PreferLinux/open-source-multimeter/design idea.png

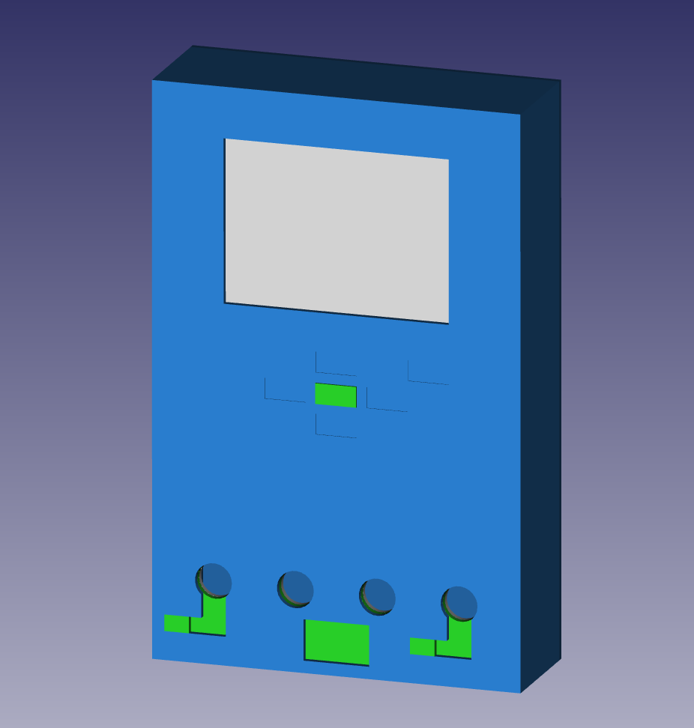
design idea.png
