PreferLinux/open-source-multimeter/README

The schematics and PCB layout are done in KiCAD.

Please see https://hackaday.io/project/10820-open-source-multimeter for details. There are also details in the schematics.
