PreferLinux/open-source-multimeter/voltage divider values.ods

Sheet: Voltage ranges
Desired resolution | Resultant peak | Resulting range | Required division | As a multiplication | Second resistor | Selected value | Actual division | Actual peak | Actual range | Actual resolution | Percentage deviation from desired | Comments
1.50E-01 | 600 | 424.2640687119 | 409.6 | 0.0024414063 | 24405.8130200685 | 2.40E+04 | 416.4894465681 | 610.0919627462 | 431.4001640052 | 0.1525229907 | 1.681993791 | These may seem high compared to my accuracy goals, but they don’t relate because these are basically the amount of rounding error between the calculated value and displayed value.
1.00E-02 | 40 | 28.2842712475 | 27.3066666667 | 0.0366210938 | 380063.779016726 | 3.90E+05 | 26.6365556775 | 39.0183921057 | 27.5901696489 | 0.009754598 | -2.4540197358
1.00E-03 | 4 | 2.8284271247 | 2.7306666667 | 0.3662109375 | 5778052.18489985 | 5.82E+06 | 2.7181929833 | 3.9817280029 | 2.8155068717 | 0.000995432 | -0.4567999275
1.00E-04 | 0.4 | 0.2828427125 | 0.2730666667 | 3.662109375 | 37564.1966250917 | 3.60E+04 | 0.2647058824 | 0.3877527574 | 0.2741826041 | 9.69381893382353E-05 | -3.0618106618 | These ranges are achieved with amplification of the signal rather than attenuation. Also used for current ranges.
1.00E-05 | 0.04 | 0.0282842712 | 0.0273066667 | 36.62109375 | 2807.3253646233 | 2.80E+03 | 0.0272373541 | 0.0398984679 | 0.0282124772 | 9.97461697470817E-06 | -0.2538302529
1.00E-06 | 0.004 | 0.0028284271 | 0.0027306667 | 366.2109375 | 273.814362419 | 2.70E+02 | 0.0026927296 | 0.0039444282 | 0.0027891319 | 9.86107042235963E-07 | -1.3892957764
Reference voltage | 3
Number of bits | 13
Max count | 4000
R1 for divider | 1.00E+07
R1 for amplifier | 1.00E+05
COM input resistor | 68

Sheet: Resistance current ranges
Desired resolution | Resultant peak V | Resulting I range | Required division | As a multiplication | Second resistor | Selected value | Actual division | Actual peak | Actual range | Actual resolution | Percentage deviation from desired | Comments
5.00E-05 | 0.2 | 0.002 | 0.1365333333 | 7.32421875 | 15812.2297714639 | 1.58E+04 | 0.1364421416 | 0.1998664184 | 0.1413268998 | 4.99666045984456E-05 | -0.0667908031 | These ranges are for measuring small currents for resistance calculations.
5.00E-06 | 0.02 | 0.0002 | 0.0136533333 | 73.2421875 | 1384.2327241268 | 1.37E+03 | 0.0135148466 | 0.0197971386 | 0.0139986909 | 4.94928464412548E-06 | -1.0143071175
Reference voltage | 3
Number of bits | 13
Max count | 4000
Shunt resistance | 100
R1 for amplifier | 1.00E+05
