PreferLinux/open-source-multimeter/External design.fcstd

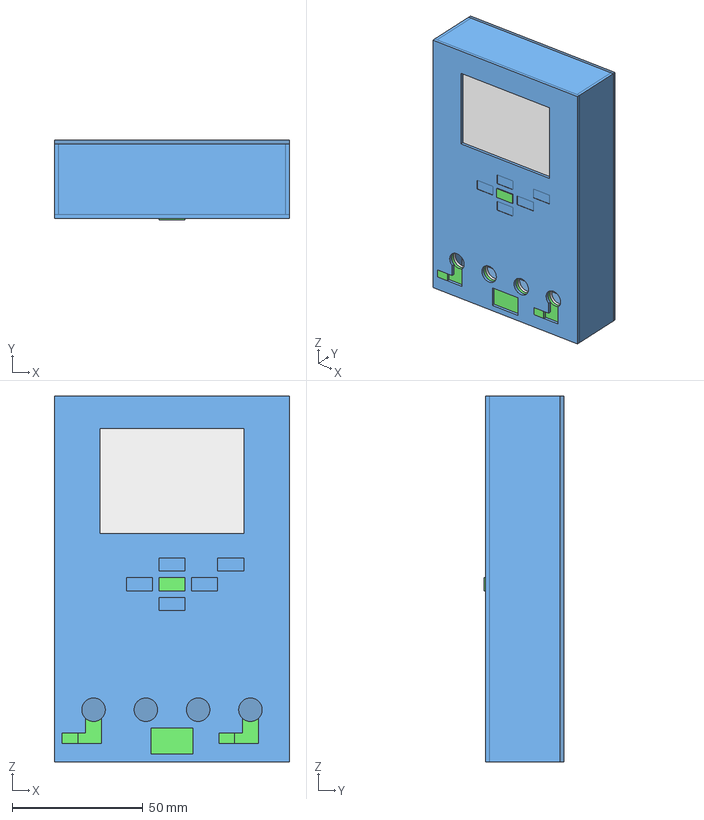
[picture p2: CAD file, 2016-07-02]
External design.fcstd
90.0 x 30.5 x 140.0 mm
