PreferLinux/open-source-multimeter/Multimeter.pdf

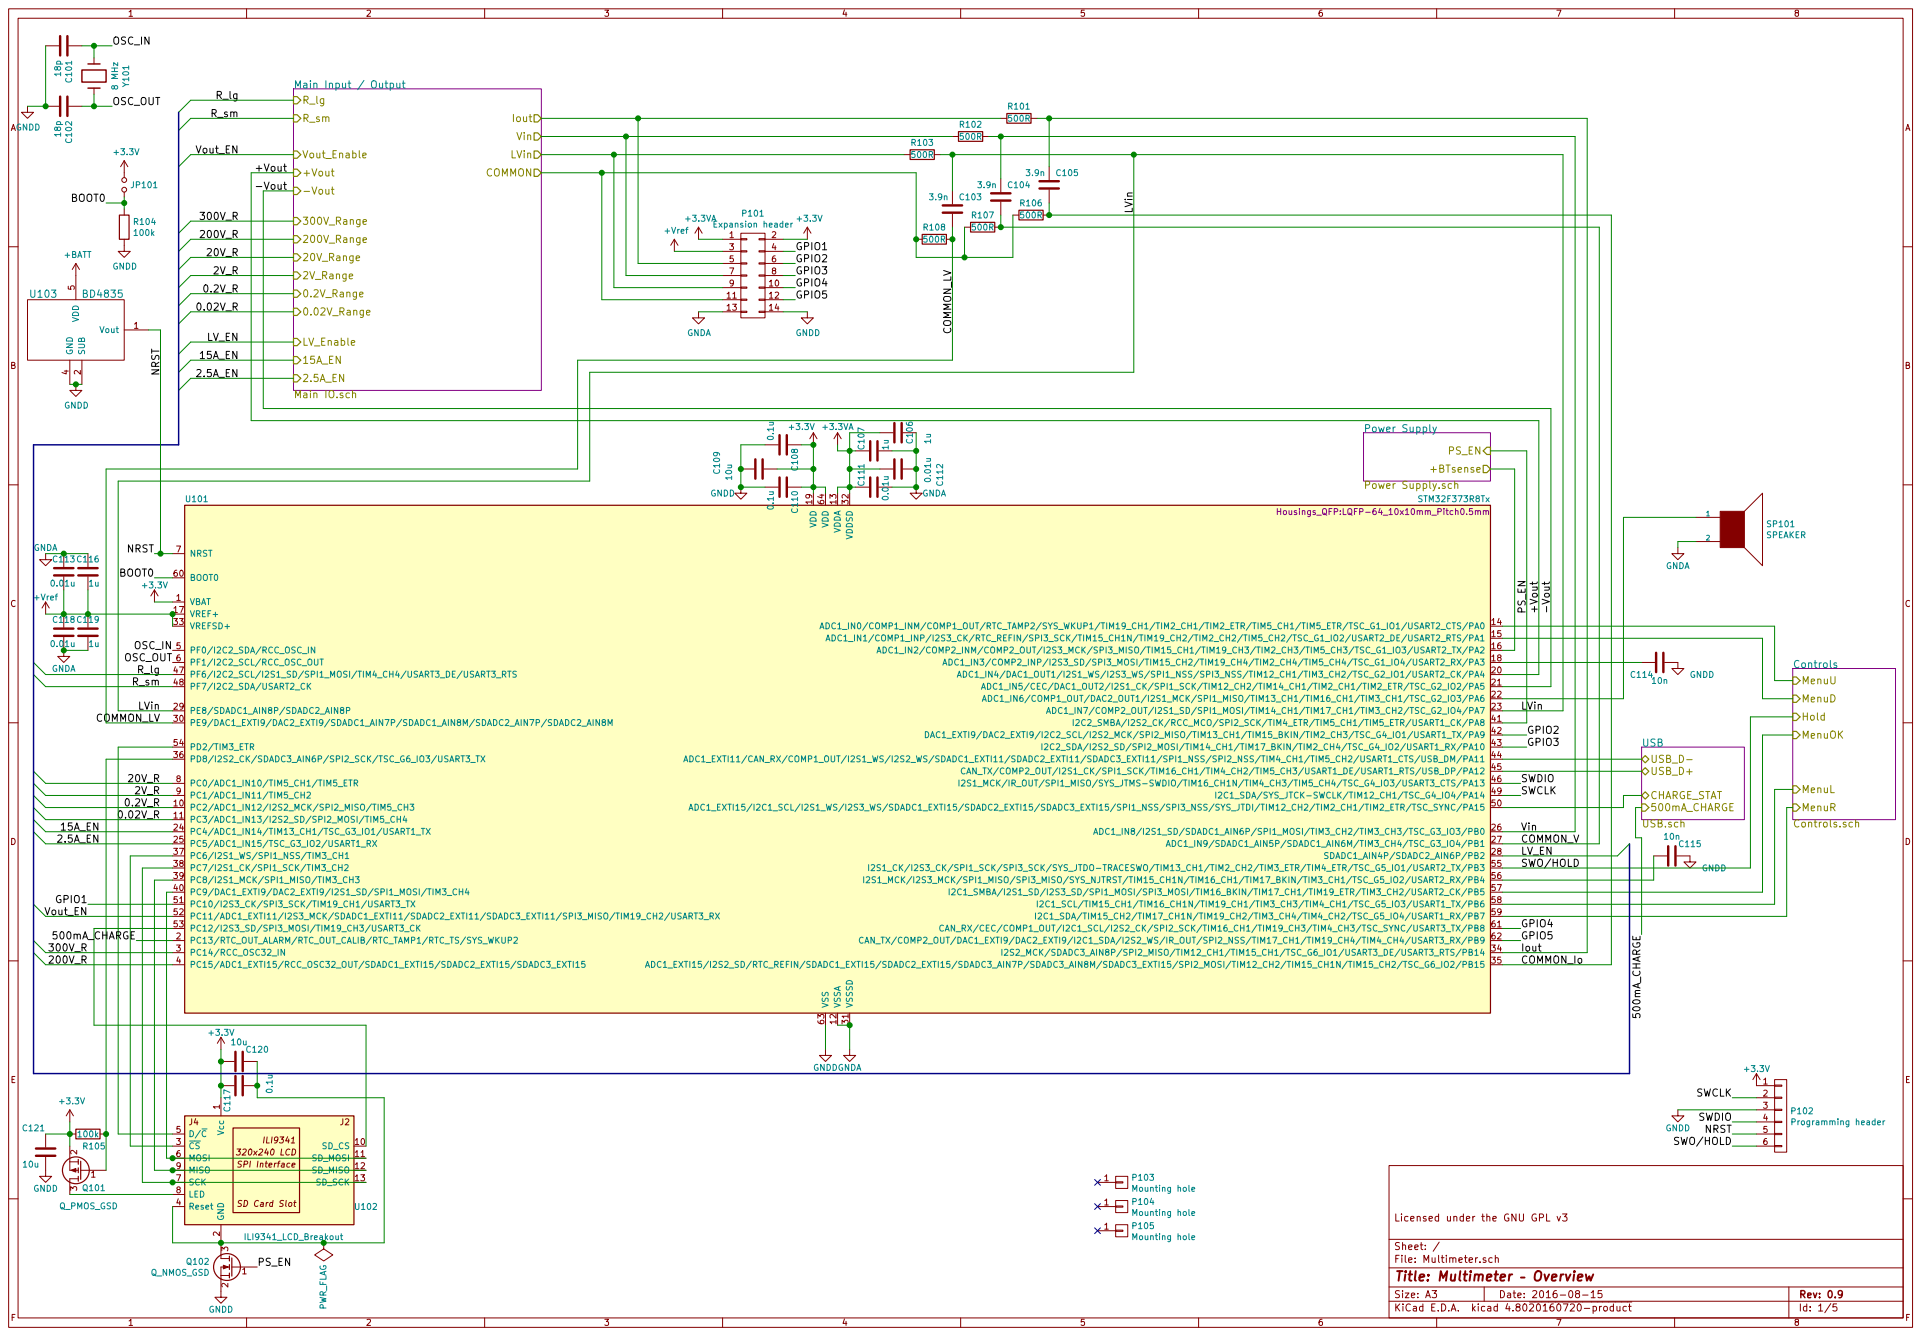
[picture p3: page 1]

Power Supply.sch
COMMON_V +Vout -Vout
Controls.sch MenuU MenuD
Hold MenuL MenuR MenuOK

2 CS 3 Reset 4 D/C 5 MOSI 6 SCK 7

File: Multimeter.sch Sheet: / Licensed under the GNU GPL v3

Id: 1/5 Title: Multimeter Overview

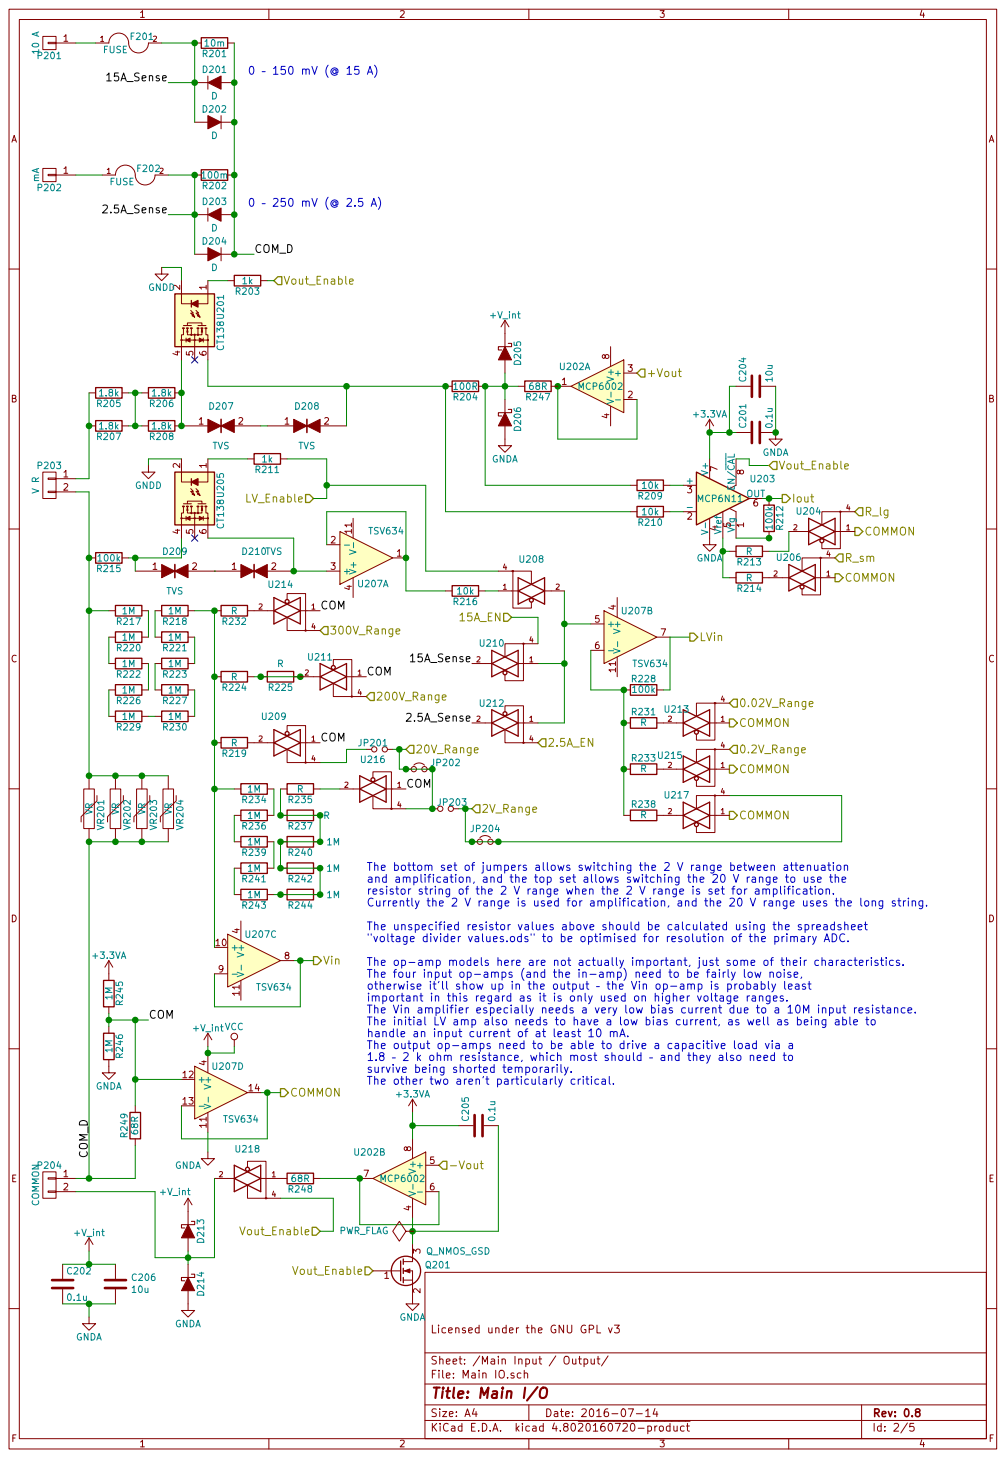
[picture p4: page 2]

The bottom set of jumpers allows switching the 2 V range between attenuation
and amplification, and the top set allows switching the 20 V range to use the
resistor string of the 2 V range when the 2 V range is set for amplification.
Currently the 2 V range is used for amplification, and the 20 V range uses the long string.
The unspecified resistor values above should be calculated using the spreadsheet
"voltage divider values.ods" to be optimised for resolution of the primary ADC.
The op-amp models here are not actually important, just some of their characteristics.
The four input op-amps (and the in-amp) need to be fairly low noise,
otherwise it'll show up in the output the Vin op-amp is probably least
important in this regard as it is only used on higher voltage ranges.
The Vin amplifier especially needs a very low bias current due to a 10M input resistance.
The initial LV amp also needs to have a low bias current, as well as being able to
handle an input current of at least 10 mA.
The output op-amps need to be able to drive a capacitive load via a
1.8 2 k ohm resistance, which most should and they also need to
survive being shorted temporarily.
The other two aren't particularly critical. 1

GNDA
File: Main IO.sch Sheet: /Main Input / Output/ Licensed under the GNU GPL v3

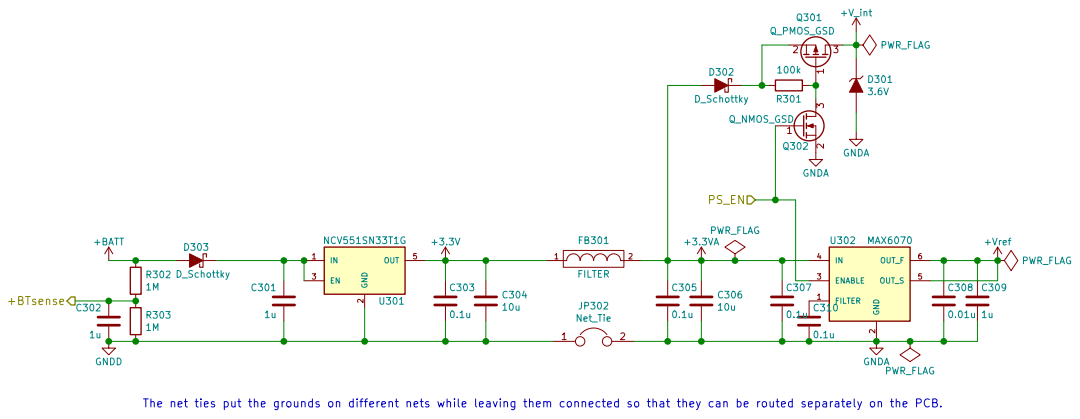
[picture p5: page 3]

Sheet: /Power Supply/ Licensed under the GNU GPL v3

File: Power Supply.sch
Id: 3/5 Title: Power supply

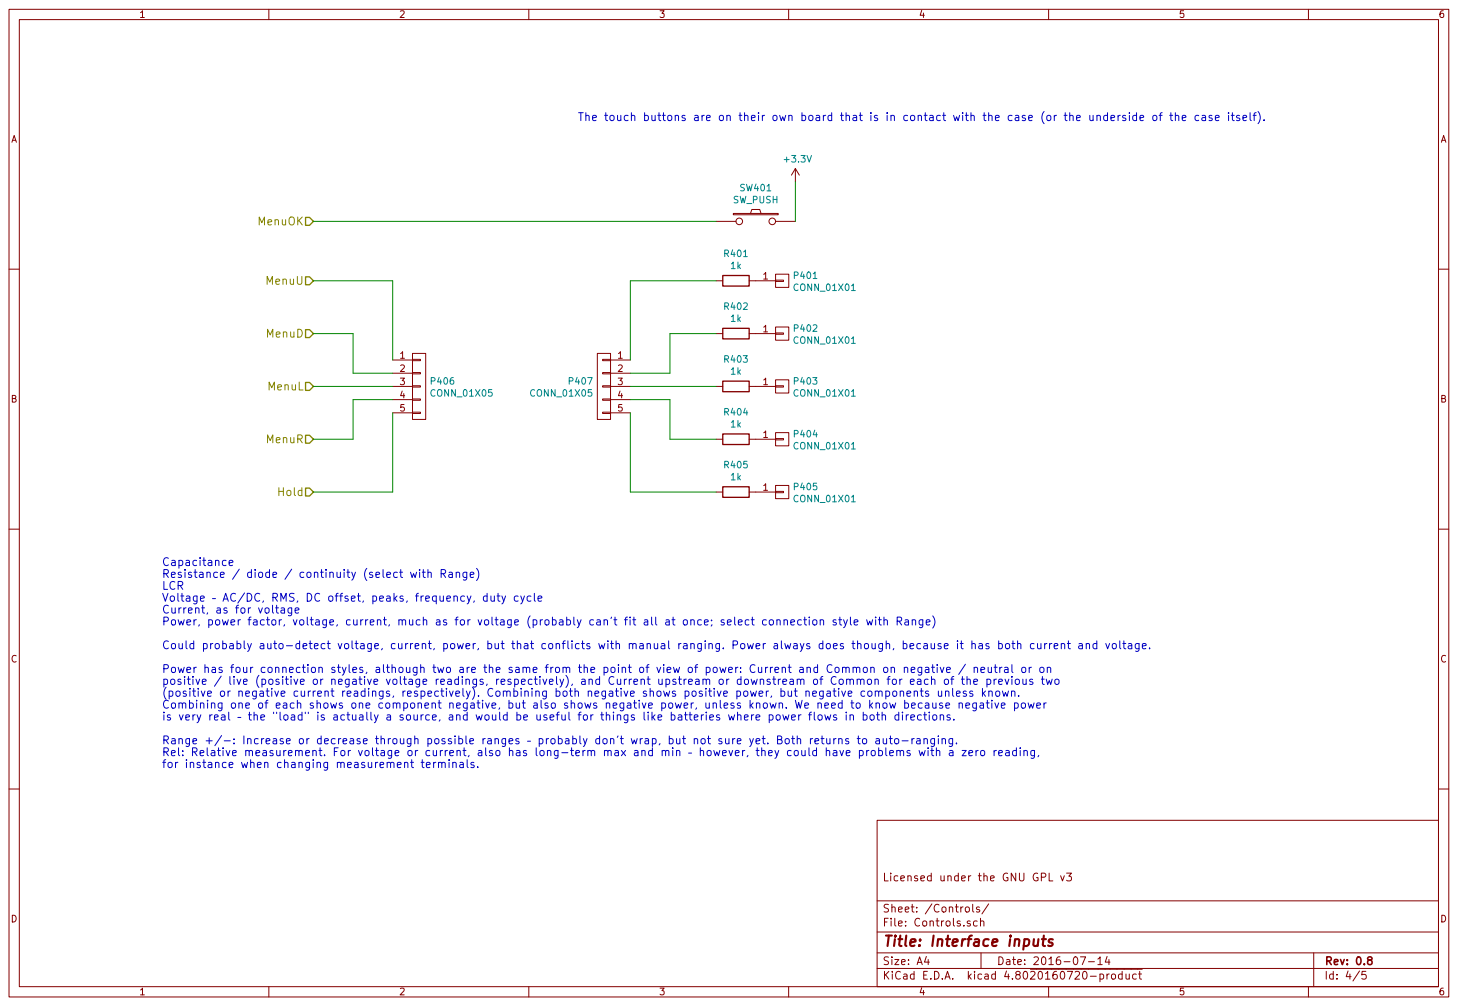
[picture p6: page 4]

The touch buttons are on their own board that is in contact with the case (or the underside of the case itself). 1

File: Controls.sch Sheet: /Controls/ Licensed under the GNU GPL v3 MenuU MenuD

Resistance / diode / continuity (select with Range)
LCR
Voltage AC/DC, RMS, DC offset, peaks, frequency, duty cycle
Current, as for voltage
Power, power factor, voltage, current, much as for voltage (probably can't fit all at once; select connection style with Range)
Could probably auto-detect voltage, current, power, but that conflicts with manual ranging. Power always does though, because it has both current and voltage.
Power has four connection styles, although two are the same from the point of view of power: Current and Common on negative / neutral or on
positive / live (positive or negative voltage readings, respectively), and Current upstream or downstream of Common for each of the previous two
(positive or negative current readings, respectively). Combining both negative shows positive power, but negative components unless known.
Combining one of each shows one component negative, but also shows negative power, unless known. We need to know because negative power
is very real the "load" is actually a source, and would be useful for things like batteries where power flows in both directions.
Range +/-: Increase or decrease through possible ranges probably don't wrap, but not sure yet. Both returns to auto-ranging.
Rel: Relative measurement. For voltage or current, also has long-term max and min however, they could have problems with a zero reading,
for instance when changing measurement terminals.

Id: 4/5 Title: Interface inputs

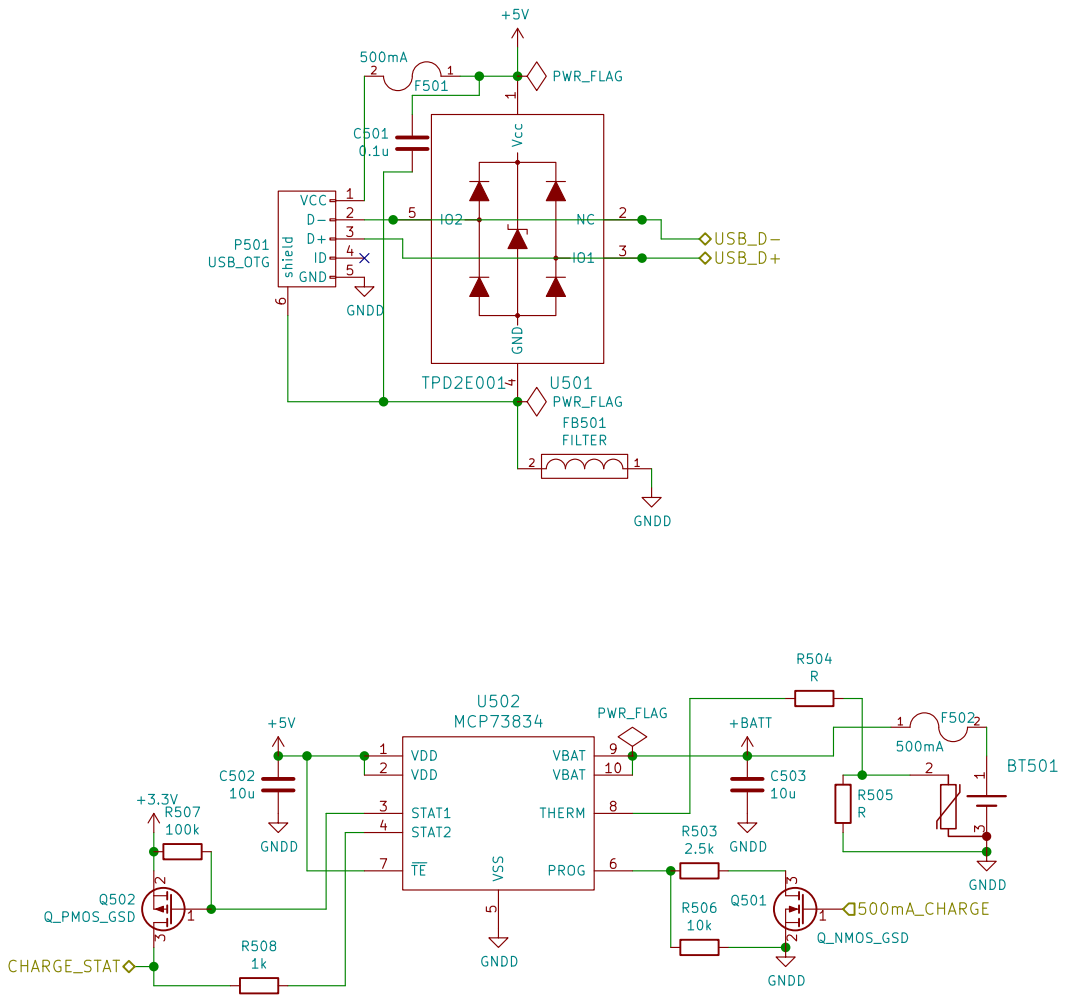
[picture p7: page 5]

5 PROG 6 TE 7 THERM 8 VBAT 9 VBAT 10 U502 MCP73834

File: USB.sch Sheet: /USB/ Licensed under the GNU GPL v3

Id: 5/5 Title: USB and charging
