PreferLinux/open-source-multimeter/Electrical design/Multimeter.kicad_pcb

## KiCad design Electrical design/Multimeter.kicad_pcb (2016-08-24)

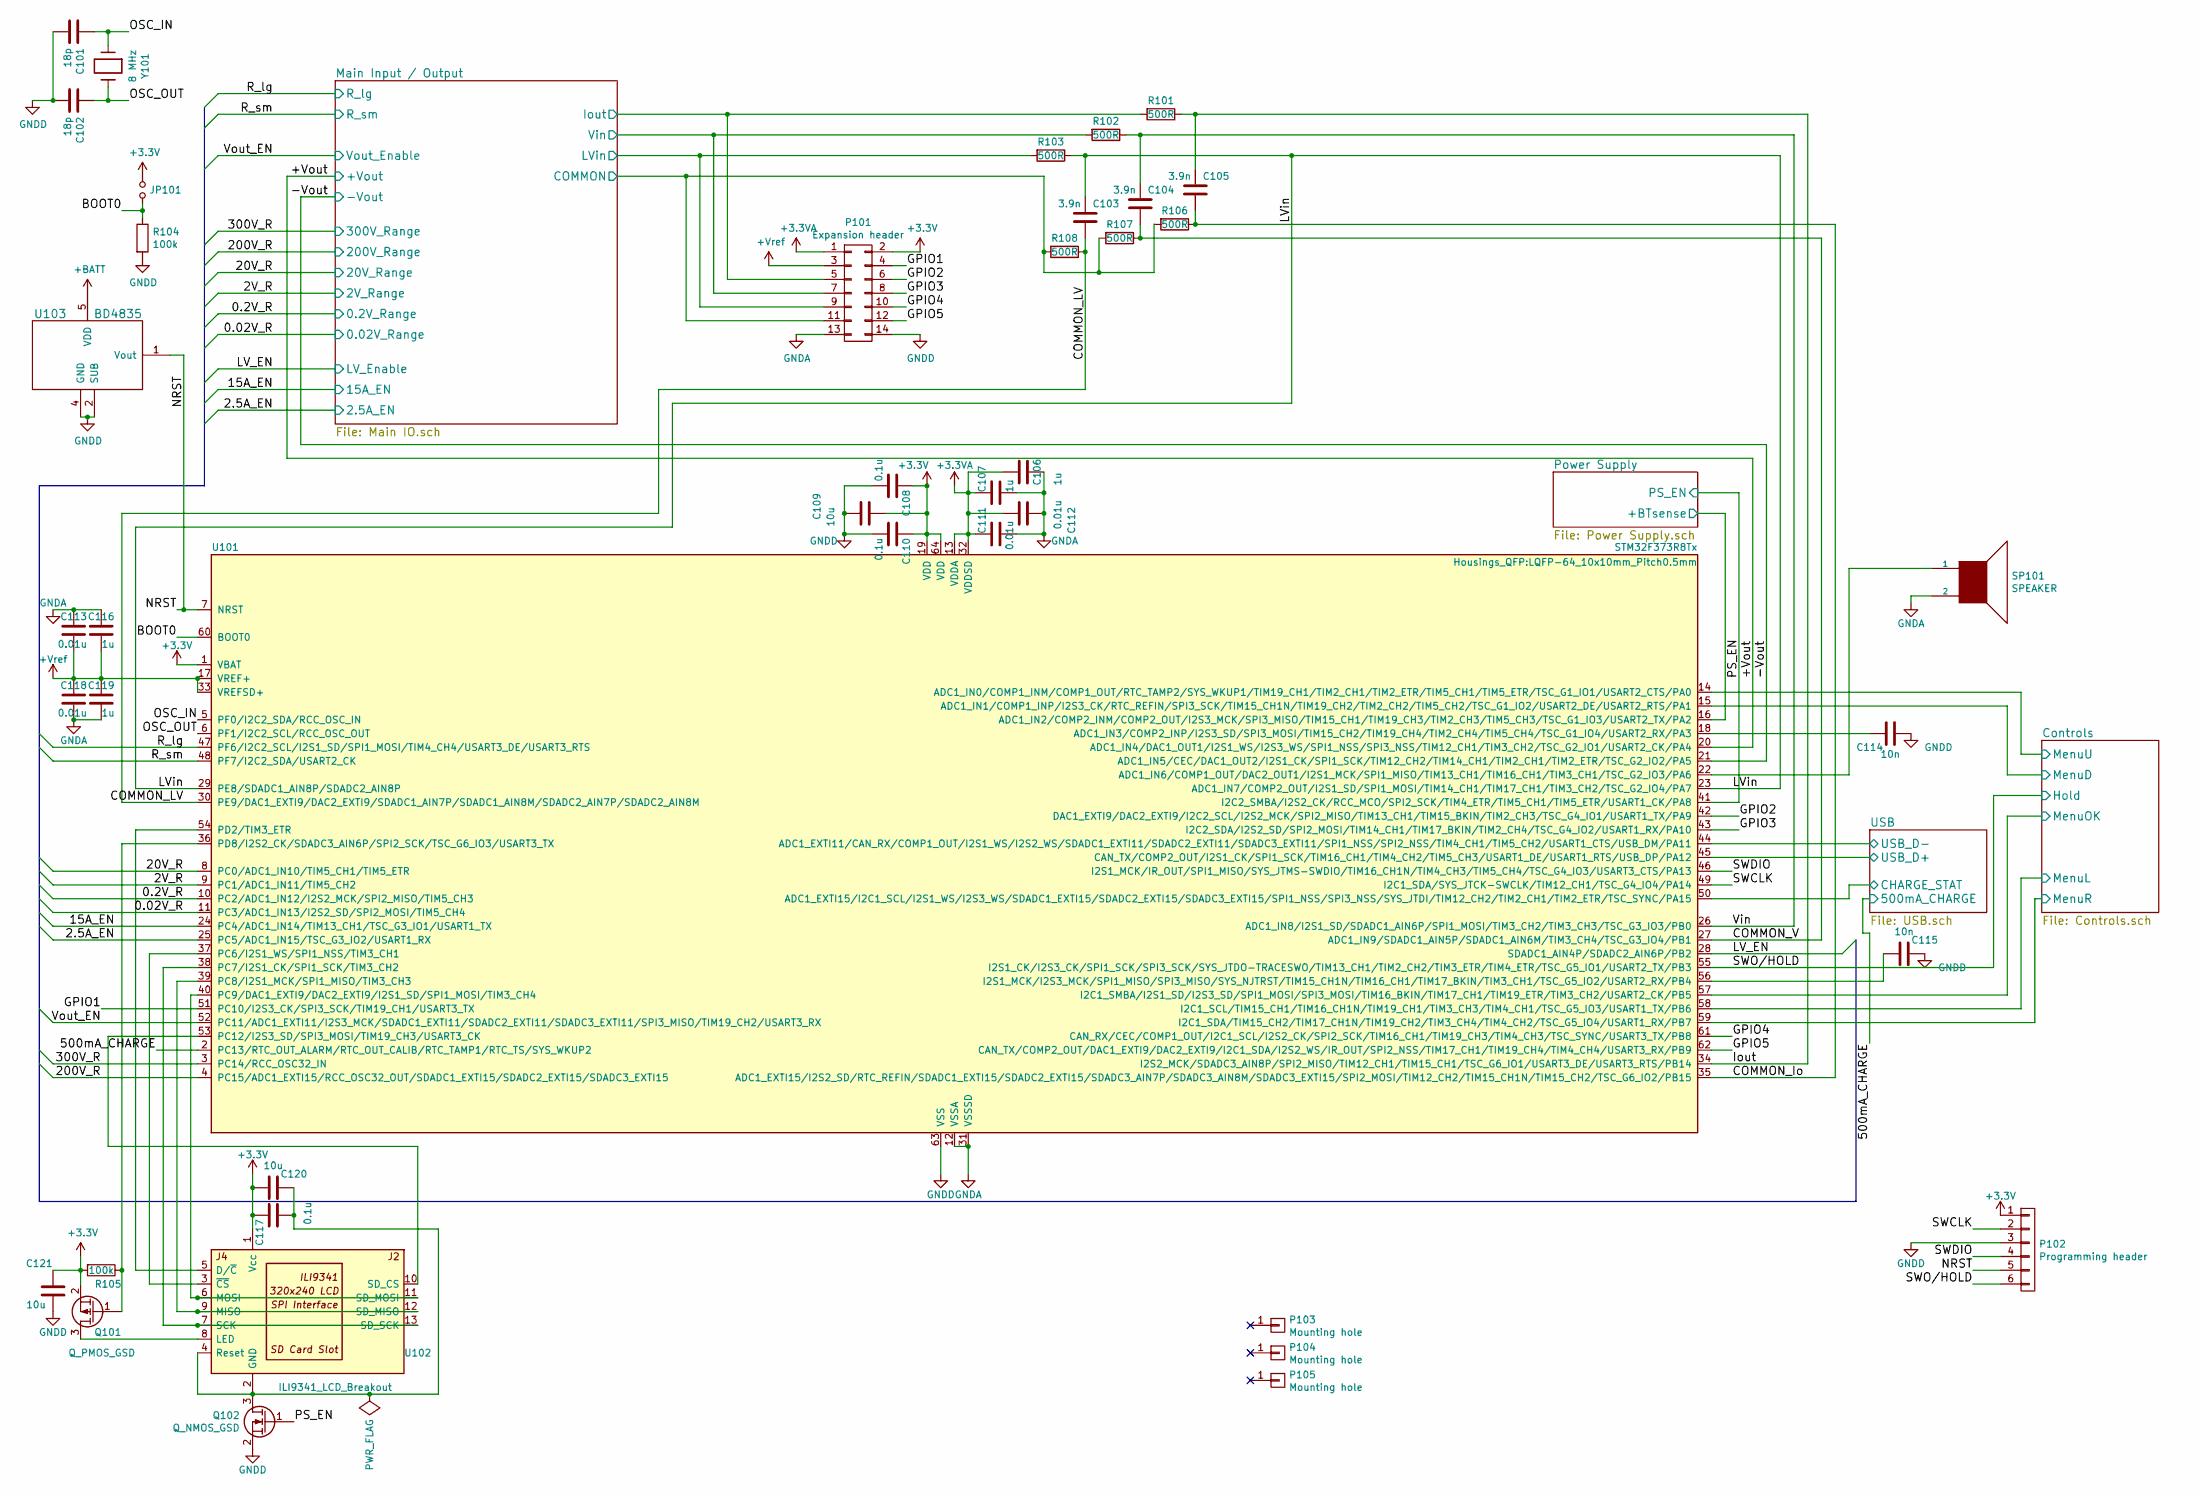
[picture p8: schematic Multimeter.sch, Multimeter – Overview]

Parts:
C101, C102: 18p; SMDuniversal_0603to0805_HandSoldering
C103, C104, C105: 3.9n; SMDuniversal_0603to0805_HandSoldering
C106, C107, C116, C119: 1u; SMDuniversal_0603to0805_HandSoldering
C108, C110, C117: 0.1u; SMDuniversal_0603to0805_HandSoldering
C109, C120, C121: 10u; SMDuniversal_0603to1206_HandSoldering
C111, C112, C113, C118: 0.01u; SMDuniversal_0603to0805_HandSoldering
C114, C115: 10n; SMDuniversal_0603to0805_HandSoldering
JP101: BOOT0; Pin_Header_Straight_1x02
P101: Expansion header; Pin_Header_Straight_2x07
P102: Programming header; Pin_Header_Straight_1x06
P103, P104, P105: Mounting hole; MountingHole_3.2mm_M3
Q101: Q_PMOS_GSD; SOT-23
Q102: Q_NMOS_GSD; SOT-23
R101, R102, R103, R106, R107, R108: 500R; SMDuniversal_0603to1210_HandSoldering
R104, R105: 100k; SMDuniversal_0603to1210_HandSoldering
SP101: SPEAKER; Pin_Header_Straight_1x02
U101: STM32F373R8Tx; LQFP-64_10x10mm_Pitch0.5mm
U102: ILI9341_LCD_Breakout
U103: BD4835; VSOF5_HandSoldering
Y101: 8 MHz; Crystal_HC49-SD_SMD

Connections:
+3.3VA: C106.2, C107.2, C111.2, C112.2, P101.1, U101.13 (VDDA), U101.32 (VDDSD); also elsewhere on the board
+3V3: C108.1, C109.2, C110.1, C117.1, C120.2, C121.1, JP101.1, P101.2, P102.1, Q101.2 (S), R105.2, U101.1 (VBAT), U101.19 (VDD), U101.64 (VDD), U102.1 (Vcc); also elsewhere on the board
+BATT: U103.5 (VDD); also elsewhere on the board
+Vref: C113.1, C116.1, C118.2, C119.2, P101.3, U101.17 (VREF+), U101.33 (VREFSD+); also elsewhere on the board
/0.2V_R: U101.10 (PC2/ADC1_IN12/I2S2_MCK/SPI2_MISO/TIM5_C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); also elsewhere on the board
/0.02V_R: U101.11 (PC3/ADC1_IN13/I2S2_SD/SPI2_MOSI/TIM5_CH4); also elsewhere on the board
/2.5A_EN: U101.25 (PC5/ADC1_IN15/TSC_G3_IO2/USART1_RX); also elsewhere on the board
/2V_R: U101.9 (PC1/ADC1_IN11/TIM5_CH2); also elsewhere on the board
/15A_EN: U101.24 (PC4/ADC1_IN14/TIM13_CH1/TSC_G3_IO1/USAR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); also elsewhere on the board
/20V_R: U101.8 (PC0/ADC1_IN10/TIM5_CH1/TIM5_ETR); also elsewhere on the board
/200V_R: U101.4 (PC15/ADC1_EXTI15/RCC_OSC32_OUT/SDADC1_E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); also elsewhere on the board
/300V_R: U101.3 (PC14/RCC_OSC32_IN); also elsewhere on the board
/500mA_CHARGE: U101.2 (PC13/RTC_OUT_ALARM/RTC_OUT_CALIB/RTC_TA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); also elsewhere on the board
/+Vout: U101.20 (ADC1_IN4/DAC1_OUT1/I2S1_WS/I2S3_WS/SPI1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); also elsewhere on the board
/-Vout: U101.21 (ADC1_IN5/CEC/DAC1_OUT2/I2S1_CK/SPI1_SCK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); also elsewhere on the board
/BOOT0: JP101.2, R104.1, U101.60 (BOOT0)
/COMMON_Io: C105.2, R106.1, U101.35 (ADC1_EXTI15/I2S2_SD/RTC_REFIN/SDADC1_EX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)
/COMMON_LV: C103.2, R108.1, U101.30 (PE9/DAC1_EXTI9/DAC2_EXTI9/SDADC1_AIN7P/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)
/COMMON_V: C104.2, R107.1, U101.27 (ADC1_IN9/SDADC1_AIN5P/SDADC1_AIN6M/TIM3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)
/Controls/MenuD: U101.15 (ADC1_IN1/COMP1_INP/I2S3_CK/RTC_REFIN/SP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); also elsewhere on the board
/Controls/MenuL: U101.58 (I2C1_SCL/TIM15_CH1/TIM16_CH1N/TIM19_CH1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); also elsewhere on the board
/Controls/MenuOK: U101.57 (I2C1_SMBA/I2S1_SD/I2S3_SD/SPI1_MOSI/SPI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); also elsewhere on the board
/Controls/MenuR: U101.59 (I2C1_SDA/TIM15_CH2/TIM17_CH1N/TIM19_CH2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); also elsewhere on the board
/Controls/MenuU: U101.14 (ADC1_IN0/COMP1_INM/COMP1_OUT/RTC_TAMP2/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); also elsewhere on the board
/GPIO1: P101.4, U101.51 (PC10/I2S3_CK/SPI3_SCK/TIM19_CH1/USART3_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)
/GPIO2: P101.6, U101.42 (DAC1_EXTI9/DAC2_EXTI9/I2C2_SCL/I2S2_MCK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)
/GPIO3: P101.8, U101.43 (I2C2_SDA/I2S2_SD/SPI2_MOSI/TIM14_CH1/TI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)
/GPIO4: P101.10, U101.61 (CAN_RX/CEC/COMP1_OUT/I2C1_SCL/I2S2_CK/S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)
/GPIO5: P101.12, U101.62 (CAN_TX/COMP2_OUT/DAC1_EXTI9/DAC2_EXTI9/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)
/Iout: C105.1, R101.1, U101.34 (I2S2_MCK/SDADC3_AIN8P/SPI2_MISO/TIM12_C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)
/LV_EN: U101.28 (SDADC1_AIN4P/SDADC2_AIN6P/PB2); also elsewhere on the board
/LVin: C103.1, R103.1, U101.23 (ADC1_IN7/COMP2_OUT/I2S1_SD/SPI1_MOSI/TI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), U101.29 (PE8/SDADC1_AIN8P/SDADC2_AIN8P)
/Main Input / Output/COMMON: P101.11, R106.2, R107.2, R108.2; also elsewhere on the board
/Main Input / Output/Iout: P101.5, R101.2; also elsewhere on the board
/Main Input / Output/LVin: P101.9, R103.2; also elsewhere on the board
/Main Input / Output/Vin: P101.7, R102.2; also elsewhere on the board
/NRST: P102.5, U101.7 (NRST), U103.1 (Vout)
/OSC_IN: C101.1, U101.5 (PF0/I2C2_SDA/RCC_OSC_IN), Y101.1
/OSC_OUT: C102.1, U101.6 (PF1/I2C2_SCL/RCC_OSC_OUT), Y101.2
/PS_EN: Q102.1 (G), U101.41 (I2C2_SMBA/I2S2_CK/RCC_MCO/SPI2_SCK/TIM4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); also elsewhere on the board
/Power Supply/+BTsense: U101.16 (ADC1_IN2/COMP2_INM/COMP2_OUT/I2S3_MCK/S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); also elsewhere on the board
/R_lg: U101.47 (PF6/I2C2_SCL/I2S1_SD/SPI1_MOSI/TIM4_CH4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); also elsewhere on the board
/R_sm: U101.48 (PF7/I2C2_SDA/USART2_CK); also elsewhere on the board
/SWCLK: P102.2, U101.49 (I2C1_SDA/SYS_JTCK-SWCLK/TIM12_CH1/TSC_G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)
/SWDIO: P102.4, U101.46 (I2S1_MCK/IR_OUT/SPI1_MISO/SYS_JTMS-SWDI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)
/SWO/HOLD: P102.6, U101.55 (I2S1_CK/I2S3_CK/SPI1_SCK/SPI3_SCK/SYS_J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); also elsewhere on the board
/USB/CHARGE_STAT: U101.50 (ADC1_EXTI15/I2C1_SCL/I2S1_WS/I2S3_WS/SD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); also elsewhere on the board
/USB/USB_D+: U101.45 (CAN_TX/COMP2_OUT/I2S1_CK/SPI1_SCK/TIM16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); also elsewhere on the board
/USB/USB_D-: U101.44 (ADC1_EXTI11/CAN_RX/COMP1_OUT/I2S1_WS/I2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); also elsewhere on the board
/Vin: C104.1, R102.1, U101.26 (ADC1_IN8/I2S1_SD/SDADC1_AIN6P/SPI1_MOSI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)
/Vout_EN: U101.52 (PC11/ADC1_EXTI11/I2S3_MCK/SDADC1_EXTI11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); also elsewhere on the board
GNDA: C106.1, C107.1, C111.1, C112.1, C113.2, C116.2, C118.1, C119.1, P101.13, SP101.2, U101.12 (VSSA), U101.31 (VSSSD); also elsewhere on the board
GNDD: C101.2, C102.2, C108.2, C109.1, C110.2, C114.1, C115.1, C121.2, P101.14, P102.3, Q102.2 (S), R104.2, U101.63 (VSS), U103.2 (SUB), U103.4 (GND); also elsewhere on the board
unnamed: C114.2, U101.18 (ADC1_IN3/COMP2_INP/I2S3_SD/SPI3_MOSI/TI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)
unnamed: C115.2, U101.56 (I2S1_MCK/I2S3_MCK/SPI1_MISO/SPI3_MISO/S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)
unnamed: C117.2, C120.1, Q102.3 (D), U102.2 (GND), U102.4 (Reset)
unnamed: Q101.1 (G), R105.1, U101.36 (PD8/I2S2_CK/SDADC3_AIN6P/SPI2_SCK/TSC_G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)
unnamed: Q101.3 (D), U102.8 (LED)
unnamed: SP101.1, U101.22 (ADC1_IN6/COMP1_OUT/DAC2_OUT1/I2S1_MCK/S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)
unnamed: U101.37 (PC6/I2S1_WS/SPI1_NSS/TIM3_CH1), U102.3 (~CS)
unnamed: U101.38 (PC7/I2S1_CK/SPI1_SCK/TIM3_CH2), U102.7 (SCK), U102.13 (SD_SCK)
unnamed: U101.39 (PC8/I2S1_MCK/SPI1_MISO/TIM3_CH3), U102.9 (MISO), U102.12 (SD_MISO)
unnamed: U101.40 (PC9/DAC1_EXTI9/DAC2_EXTI9/I2S1_SD/SPI1_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), U102.6 (MOSI), U102.11 (SD_MOSI)
unnamed: U101.53 (PC12/I2S3_SD/SPI3_MOSI/TIM19_CH3/USART3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), U102.10 (SD_CS)
unnamed: U101.54 (PD2/TIM3_ETR), U102.5 (D/~C)

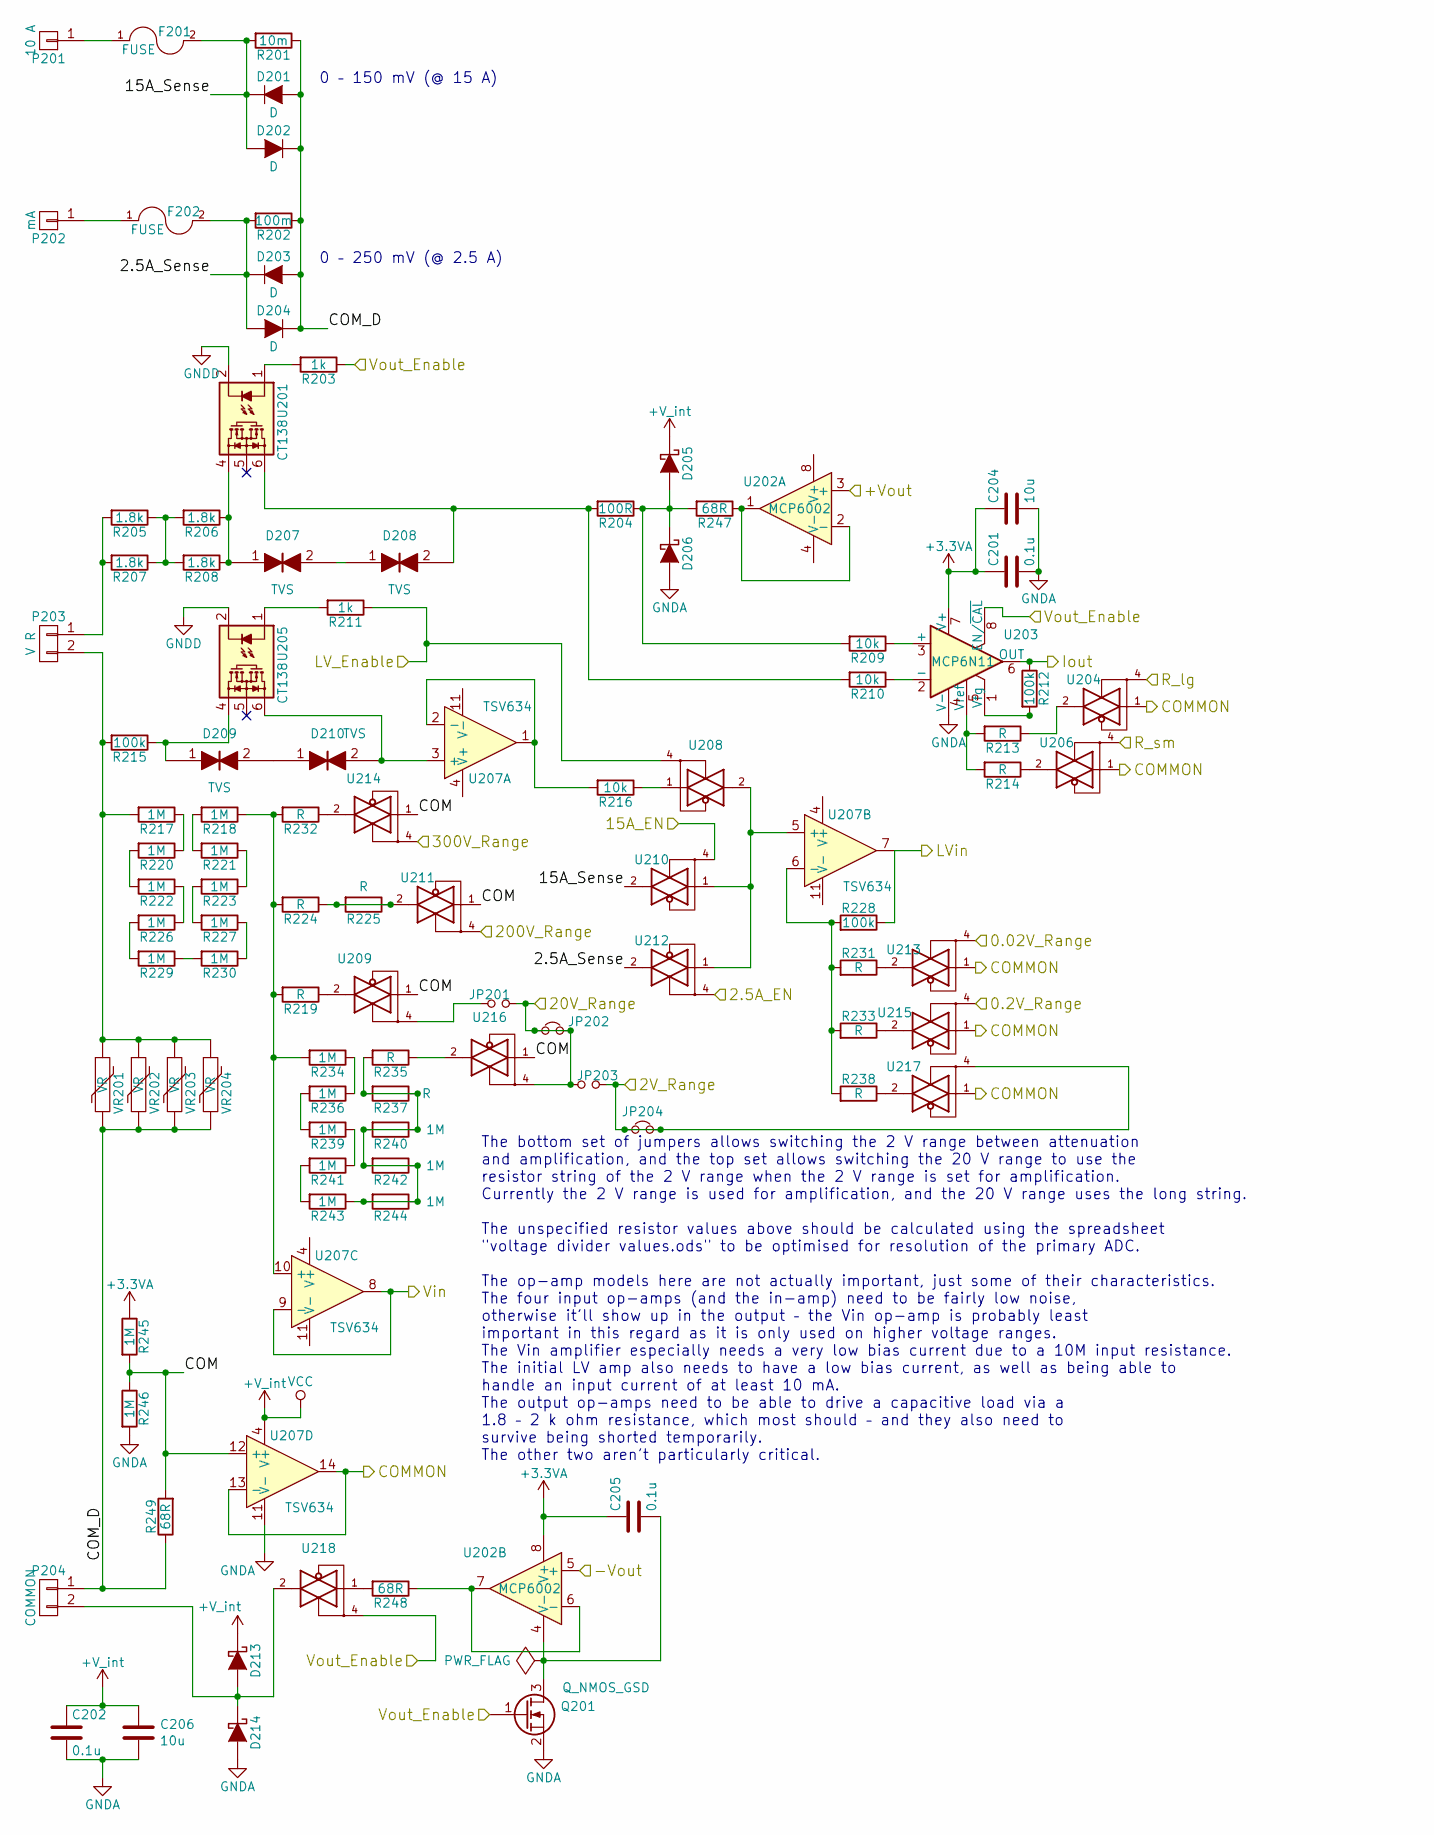
[picture p9: schematic Main IO.sch, Main I/O]

Parts:
C201, C202, C205: 0.1u; SMDuniversal_0603to0805_HandSoldering
C204, C206: 10u; SMDuniversal_0603to1206_HandSoldering
D201, D202, D203, D204: D; Diode_R-6_Horizontal_RM15
D205, D206, D213, D214: D_Schottky; SC-90A
D207, D208, D209, D210: TVS; SMB_Handsoldering
F201, F202: FUSE; Fuseholder6x32_horiz_open_inline_Type-I
JP201, JP203: Jumper_NO_Small; R_0603_HandSoldering
JP202, JP204: Jumper_NC_Small; R_0603_HandSoldering
P201: 10 A; Banana_Jack_1Pin
P202: mA; Banana_Jack_1Pin
P203: V R; Banana_Jack_1Pin_2Contact_SM_Top
P204: COMMON; Banana_Jack_1Pin_2Contact_SM_Top
Q201: Q_NMOS_GSD; SOT-23
R201: 10m; Resistor_SMD+THTuniversal_0805to2512_RM10_HandSoldering
R202: 100m; Resistor_SMD+THTuniversal_0805to2512_RM10_HandSoldering
R203, R211: 1k; SMDuniversal_0603to1210_HandSoldering
R204: 100R; SMDuniversal_0603to1210_HandSoldering
R205, R206, R207, R208: 1.8k; Resistor_SMDuniversal_0805to2512_HandSoldering
R209, R210, R216: 10k; SMDuniversal_0603to1210_HandSoldering
R212, R228: 100k; SMDuniversal_0603to1210_HandSoldering
R213, R214, R219, R224, R225, R231, R232, R233, R235, R237, R238: R; SMDuniversal_0603to1210_HandSoldering
R215: 100k; Resistor_Horizontal_RM20mm
R217, R218, R220, R221, R222, R223, R226, R227, R229, R230, R234, R236, R239, R240, R241, R242, R243, R244, R245, R246: 1M; SMDuniversal_0603to1210_HandSoldering
R247, R248, R249: 68R; SMDuniversal_0603to1210_HandSoldering
U201, U205: CT138; DIP-6_W7.62mm_LongPads
U202: MCP6002; MSOP-8_3x3mm_Pitch0.65mm
U203: MCP6N11; SOIC-8_3.9x4.9mm_Pitch1.27mm
U204, U206, U208, U209, U210, U211, U212, U213, U214, U215, U216, U217, U218: 74LVC1G66 GNDA; SOT-353
U207: TSV634; TSSOP-14_4.4x5mm_Pitch0.65mm
VR201, VR202, VR203, VR204: VR; RV_Disc_D15.5_W5.4_P7.5

Connections:
+3.3VA: C201.1, C204.1, C205.1, R245.1, U202.8 (V+), U203.7 (V+); also elsewhere on the board
+V_int: C202.1, C206.2, D205.1 (K), D213.1 (K), U204.5 (VCC), U206.5 (VCC), U207.4 (V+), U208.5 (VCC), U209.5 (VCC), U210.5 (VCC), U211.5 (VCC), U212.5 (VCC), U213.5 (VCC), U214.5 (VCC), U215.5 (VCC), U216.5 (VCC), U217.5 (VCC), U218.5 (VCC); also elsewhere on the board
/0.2V_R: U215.4; also elsewhere on the board
/0.02V_R: U213.4; also elsewhere on the board
/2.5A_EN: U212.4; also elsewhere on the board
/2V_R: JP203.2, JP204.1, JP204.2, U217.4; also elsewhere on the board
/15A_EN: U210.4; also elsewhere on the board
/20V_R: JP201.2, JP202.1, JP202.2, JP203.1, U216.4; also elsewhere on the board
/200V_R: U211.4; also elsewhere on the board
/300V_R: U214.4; also elsewhere on the board
/+Vout: U202.3 (+); also elsewhere on the board
/-Vout: U202.5 (+); also elsewhere on the board
/LV_EN: R211.1, U208.4; also elsewhere on the board
/Main Input / Output/2.5A_Sense: D203.1 (K), D204.2 (A), F202.2, R202.2, U212.2
/Main Input / Output/15A_Sense: D201.1 (K), D202.2 (A), F201.2, R201.2, U210.2
/Main Input / Output/COM: R245.2, R246.1, R249.2, U207.12 (+), U209.1, U211.1, U214.1, U216.1
/Main Input / Output/COMMON: U204.1, U206.1, U207.13 (-), U207.14, U213.1, U215.1, U217.1; also elsewhere on the board
/Main Input / Output/COM_D: D201.2 (A), D202.1 (K), D203.2 (A), D204.1 (K), P204.1, R201.1, R202.1, R249.1, VR201.2, VR202.2, VR203.2, VR204.2
/Main Input / Output/Iout: R212.1, U203.6 (OUT); also elsewhere on the board
/Main Input / Output/LVin: R228.1, U207.7; also elsewhere on the board
/Main Input / Output/Vin: U207.8, U207.9 (-); also elsewhere on the board
/R_lg: U204.4; also elsewhere on the board
/R_sm: U206.4; also elsewhere on the board
/Vout_EN: Q201.1 (G), R203.1, U203.8 (EN/~CAL), U218.4; also elsewhere on the board
GNDA: C201.2, C202.2, C204.2, C206.1, D206.2 (A), D214.2 (A), Q201.2 (S), R246.2, U203.4 (V-), U204.3 (GNDA), U206.3 (GNDA), U207.11 (V-), U208.3 (GNDA), U209.3 (GNDA), U210.3 (GNDA), U211.3 (GNDA), U212.3 (GNDA), U213.3 (GNDA), U214.3 (GNDA), U215.3 (GNDA), U216.3 (GNDA), U217.3 (GNDA), U218.3 (GNDA); also elsewhere on the board
GNDD: U201.2, U205.2; also elsewhere on the board
unnamed: C205.2, Q201.3 (D), U202.4 (V-)
unnamed: D205.2 (A), D206.1 (K), R204.1, R209.2, R247.2
unnamed: D207.1, R206.1, R208.1, U201.4
unnamed: D207.2, D208.1
unnamed: D208.2, R204.2, R210.2, U201.6
unnamed: D209.1, R215.1, U205.4
unnamed: D209.2, D210.1
unnamed: D210.2, U205.6, U207.3 (+)
unnamed: D213.2 (A), D214.1 (K), P204.2, U218.2
unnamed: F201.1, P201.1
unnamed: F202.1, P202.1
unnamed: JP201.1, U209.4
unnamed: P203.1, R205.2, R207.2
unnamed: P203.2, R215.2, R217.2, VR201.1, VR202.1, VR203.1, VR204.1
unnamed: R203.2, U201.1
unnamed: R205.1, R206.2, R207.1, R208.2
unnamed: R209.1, U203.3 (+)
unnamed: R210.1, U203.2 (-)
unnamed: R211.2, U205.1
unnamed: R212.2, U203.1 (Vfg)
unnamed: R213.1, U204.2
unnamed: R213.2, R214.2, U203.5 (Vref)
unnamed: R214.1, U206.2
unnamed: R216.1, U208.1
unnamed: R216.2, U207.1, U207.2 (-)
unnamed: R217.1, R220.1
unnamed: R218.1, R219.2, R224.2, R232.2, R234.2, U207.10 (+)
unnamed: R218.2, R221.2
unnamed: R219.1, U209.2
unnamed: R220.2, R222.2
unnamed: R221.1, R223.1
unnamed: R222.1, R226.1
unnamed: R223.2, R227.2
unnamed: R224.1, R225.1, R225.2, U211.2
unnamed: R226.2, R229.2
unnamed: R227.1, R230.1
unnamed: R228.2, R231.2, R233.2, R238.2, U207.6 (-)
unnamed: R229.1, R230.2
unnamed: R231.1, U213.2
unnamed: R232.1, U214.2
unnamed: R233.1, U215.2
unnamed: R234.1, R236.1
unnamed: R235.1, U216.2
unnamed: R235.2, R237.1, R237.2, R240.1, R240.2, R242.1, R242.2, R243.1, R244.1, R244.2
unnamed: R236.2, R239.2
unnamed: R238.1, U217.2
unnamed: R239.1, R241.1
unnamed: R241.2, R243.2
unnamed: R247.1, U202.1, U202.2 (-)
unnamed: R248.1, U202.6 (-), U202.7
unnamed: R248.2, U218.1
unnamed: U207.5 (+), U208.2, U210.1, U212.1

Notes on the sheet:
0 – 150 mV (@ 15 A)
0 – 250 mV (@ 2.5 A)
The bottom set of jumpers allows switching the 2 V range between attenuation and amplification, and the top set allows switching the 20 V range to use the resistor string of the 2 V range when the 2 V range is set for amplification. Currently the 2 V range is used for amplification, and the 20 V ra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

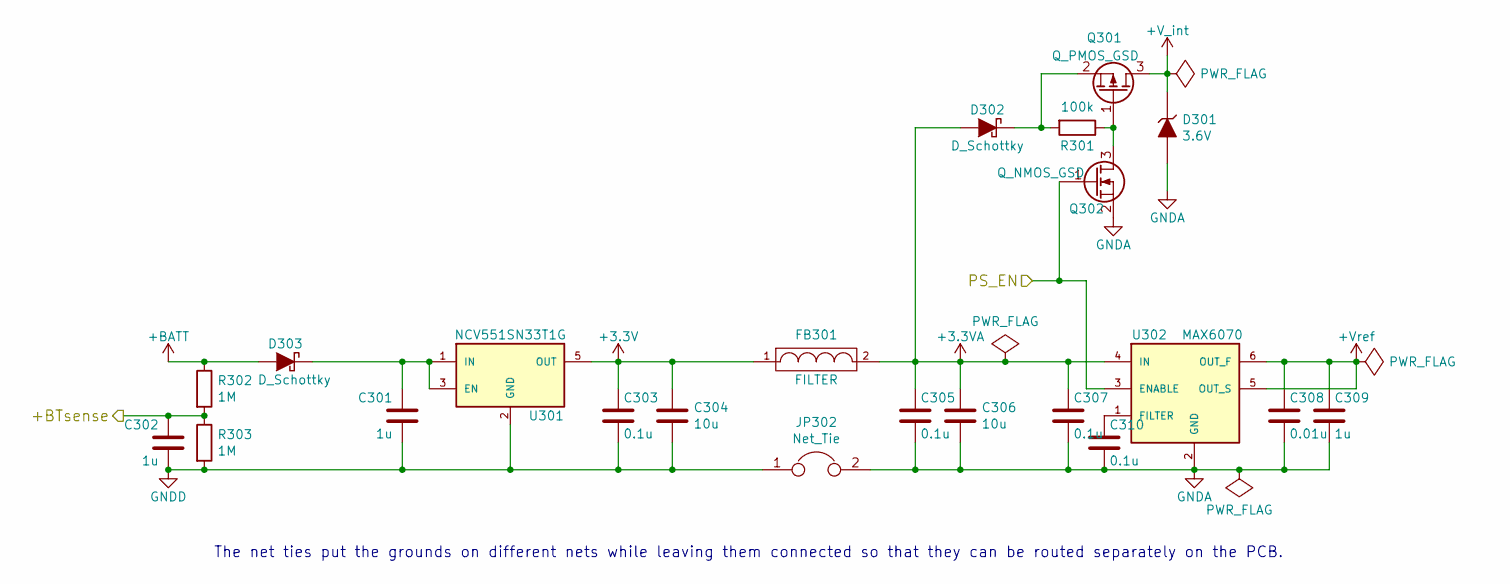
[picture p10: schematic Power Supply.sch]

Parts:
C301, C302, C309: 1u; SMDuniversal_0603to0805_HandSoldering
C303, C305, C307, C310: 0.1u; SMDuniversal_0603to0805_HandSoldering
C304, C306: 10u; SMDuniversal_0603to1206_HandSoldering
C308: 0.01u; SMDuniversal_0603to0805_HandSoldering
D301: 3.6V; SOT-23
D302, D303: D_Schottky; SC-90A
FB301: FILTER; SMDuniversal_0603to1210_HandSoldering
JP302: Net_Tie
Q301: Q_PMOS_GSD; SOT-23
Q302: Q_NMOS_GSD; SOT-23
R301: 100k; SMDuniversal_0603to1210_HandSoldering
R302, R303: 1M; SMDuniversal_0603to1210_HandSoldering
U301: NCV551SN33T1G; SOT-23-5
U302: MAX6070; SOT-23-6_Handsoldering

Connections:
+3.3VA: C305.1, C306.1, C307.1, D302.2 (A), FB301.2, U302.4 (IN); also elsewhere on the board
+3V3: C303.1, C304.1, FB301.1, U301.5 (OUT); also elsewhere on the board
+BATT: D303.2 (A), R302.1; also elsewhere on the board
+V_int: D301.3 (K), Q301.3 (D); also elsewhere on the board
+Vref: C308.1, C309.1, U302.5 (OUT_S), U302.6 (OUT_F); also elsewhere on the board
/PS_EN: Q302.1 (G), U302.3 (ENABLE); also elsewhere on the board
/Power Supply/+BTsense: C302.1, R302.2, R303.1; also elsewhere on the board
GNDA: C305.2, C306.2, C307.2, C308.2, C309.2, C310.2, D301.1 (A), JP302.2, Q302.2 (S), U302.2 (GND); also elsewhere on the board
GNDD: C301.2, C302.2, C303.2, C304.2, JP302.1, R303.2, U301.2 (GND); also elsewhere on the board
unnamed: C301.1, D303.1 (K), U301.1 (IN), U301.3 (EN)
unnamed: C310.1, U302.1 (FILTER)
unnamed: D302.1 (K), Q301.2 (S), R301.2
unnamed: Q301.1 (G), Q302.3 (D), R301.1

Notes on the sheet:
The net ties put the grounds on different nets while leaving them connected so that they can be routed separately on the PCB.

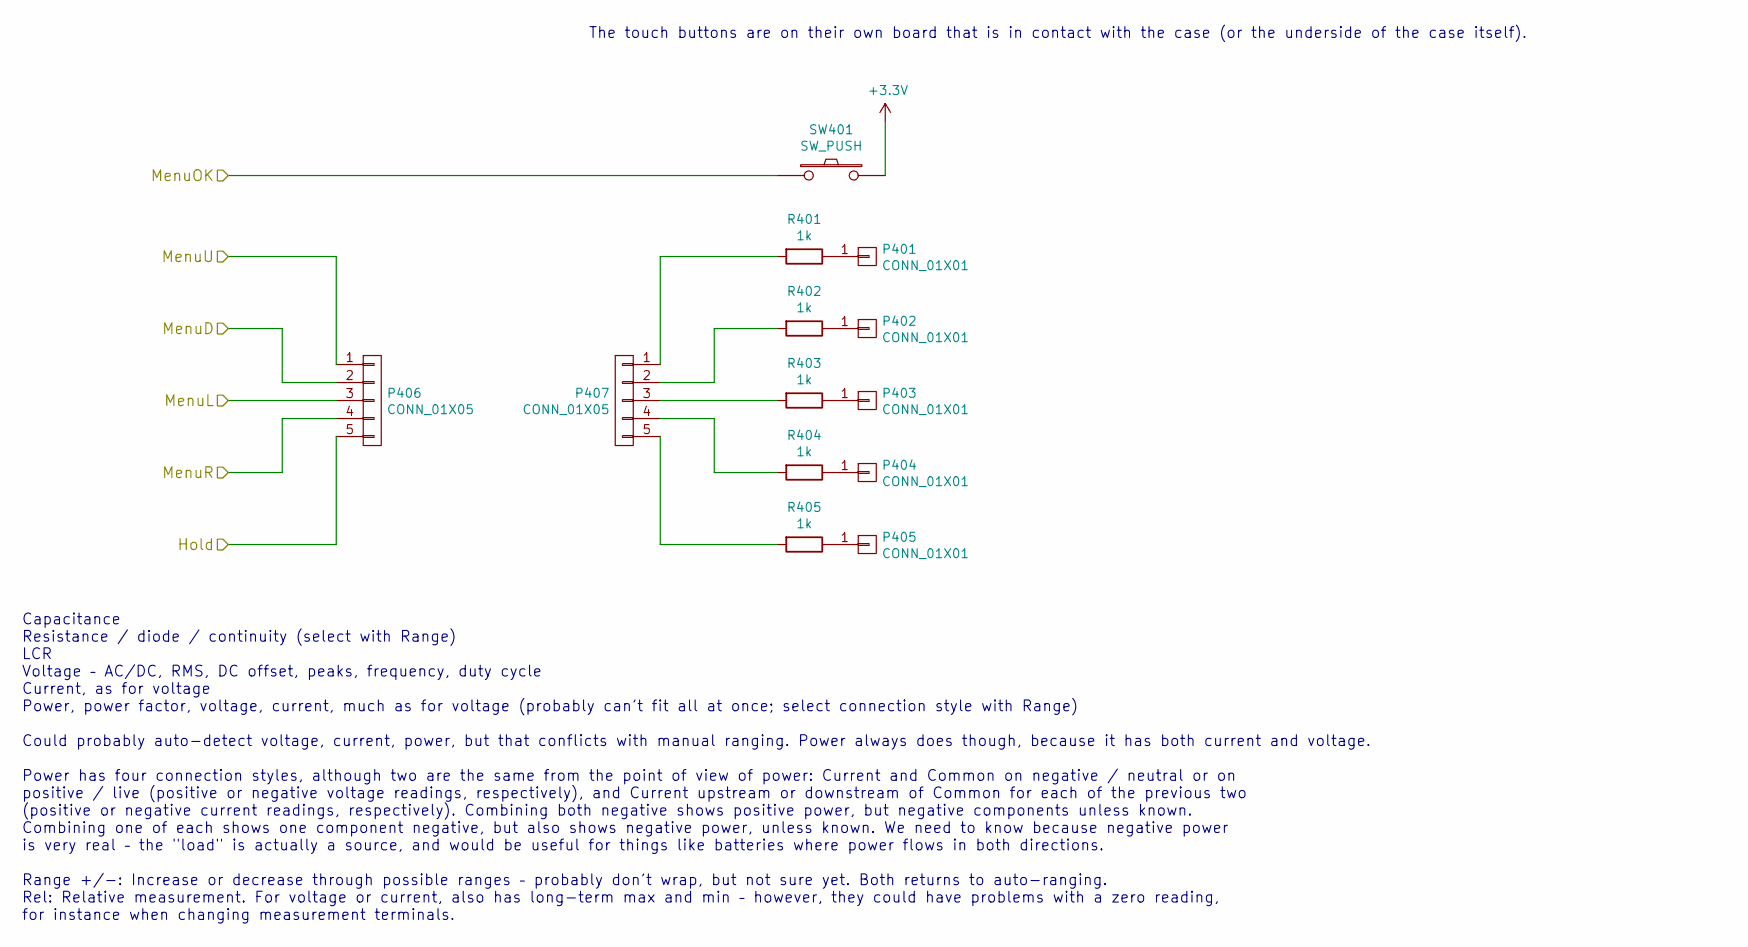
[picture p11: schematic Controls.sch, Interface inputs]

Parts:
P401, P402, P403, P404, P405: CONN_01X01; SolderWirePad_single_SMD_5x10mm
P406, P407: CONN_01X05; Pin_Header_Straight_1x05
R401, R402, R403, R404, R405: 1k; SMDuniversal_0603to1210_HandSoldering
SW401: SW_PUSH; SW_PUSH_SMALL

Connections:
+3V3: SW401.2; also elsewhere on the board
/Controls/MenuD: P406.2; also elsewhere on the board
/Controls/MenuL: P406.3; also elsewhere on the board
/Controls/MenuOK: SW401.1; also elsewhere on the board
/Controls/MenuR: P406.4; also elsewhere on the board
/Controls/MenuU: P406.1; also elsewhere on the board
/SWO/HOLD: P406.5; also elsewhere on the board
unnamed: P401.1, R401.1
unnamed: P402.1, R402.1
unnamed: P403.1, R403.1
unnamed: P404.1, R404.1
unnamed: P405.1, R405.1
unnamed: P407.1, R401.2
unnamed: P407.2, R402.2
unnamed: P407.3, R403.2
unnamed: P407.4, R404.2
unnamed: P407.5, R405.2

Notes on the sheet:
Capacitance Resistance / diode / continuity (select with Range) LCR Voltage – AC/DC, RMS, DC offset, peaks, frequency, duty cycle Current, as for voltage Power, power factor, voltage, current, much as for voltage (probably can't fit all at once; select connection style with Range) Could probably au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
The touch buttons are on their own board that is in contact with the case (or the underside of the case itself).

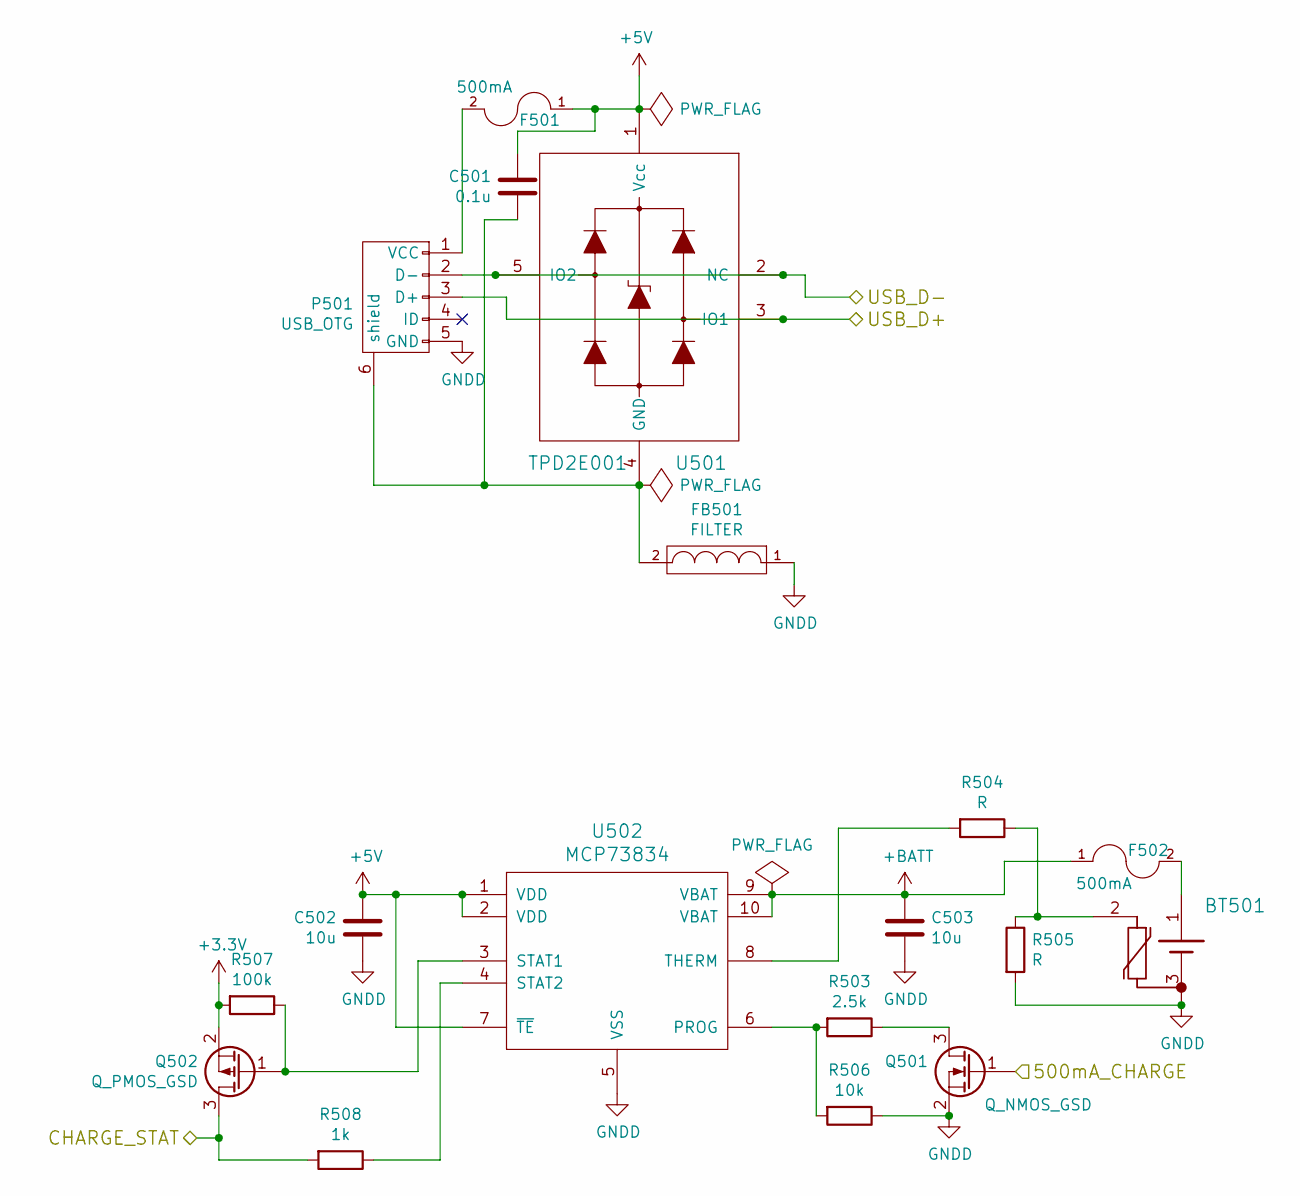
[picture p12: schematic USB.sch, USB and charging]

Parts:
BT501: Li-Ion_Cell; Pin_Header_Straight_1x03
C501: 0.1u; SMDuniversal_0603to0805_HandSoldering
C502, C503: 10u; SMDuniversal_0603to1206_HandSoldering
F501, F502: 500mA; R_1210_HandSoldering
FB501: FILTER; SMDuniversal_0603to1210_HandSoldering
P501: USB_OTG; MicroUSB_B_Vertical
Q501: Q_NMOS_GSD; SOT-23
Q502: Q_PMOS_GSD; SOT-23
R503: 2.5k; SMDuniversal_0603to1210_HandSoldering
R504, R505: R; SMDuniversal_0603to1210_HandSoldering
R506: 10k; SMDuniversal_0603to1210_HandSoldering
R507: 100k; SMDuniversal_0603to1210_HandSoldering
R508: 1k; SMDuniversal_0603to1210_HandSoldering
U501: TPD2E001; VSOF5_HandSoldering
U502: MCP73834; MSOP-10_3x3mm_Pitch0.5mm

Connections:
+3V3: Q502.2 (S), R507.2; also elsewhere on the board
+5V: C501.2, C502.1, F501.1, U501.1 (Vcc), U502.1 (VDD), U502.2 (VDD), U502.7 (~TE)
+BATT: C503.1, F502.1, U502.9 (VBAT), U502.10 (VBAT); also elsewhere on the board
/500mA_CHARGE: Q501.1 (G); also elsewhere on the board
/USB/CHARGE_STAT: Q502.3 (D), R508.2; also elsewhere on the board
/USB/USB_D+: P501.3 (D+), U501.3 (IO1); also elsewhere on the board
/USB/USB_D-: P501.2 (D-), U501.2 (NC), U501.5 (IO2); also elsewhere on the board
GNDD: BT501.3, C502.2, C503.2, FB501.1, P501.5 (GND), Q501.2 (S), R505.2, R506.1, U502.5 (VSS); also elsewhere on the board
unnamed: BT501.1, F502.2
unnamed: BT501.2, R504.1, R505.1
unnamed: C501.1, FB501.2, P501.6 (shield), U501.4 (GND)
unnamed: F501.2, P501.1 (VCC)
unnamed: Q501.3 (D), R503.1
unnamed: Q502.1 (G), R507.1, U502.3 (STAT1)
unnamed: R503.2, R506.2, U502.6 (PROG)
unnamed: R504.2, U502.8 (THERM)
unnamed: R508.1, U502.4 (STAT2)

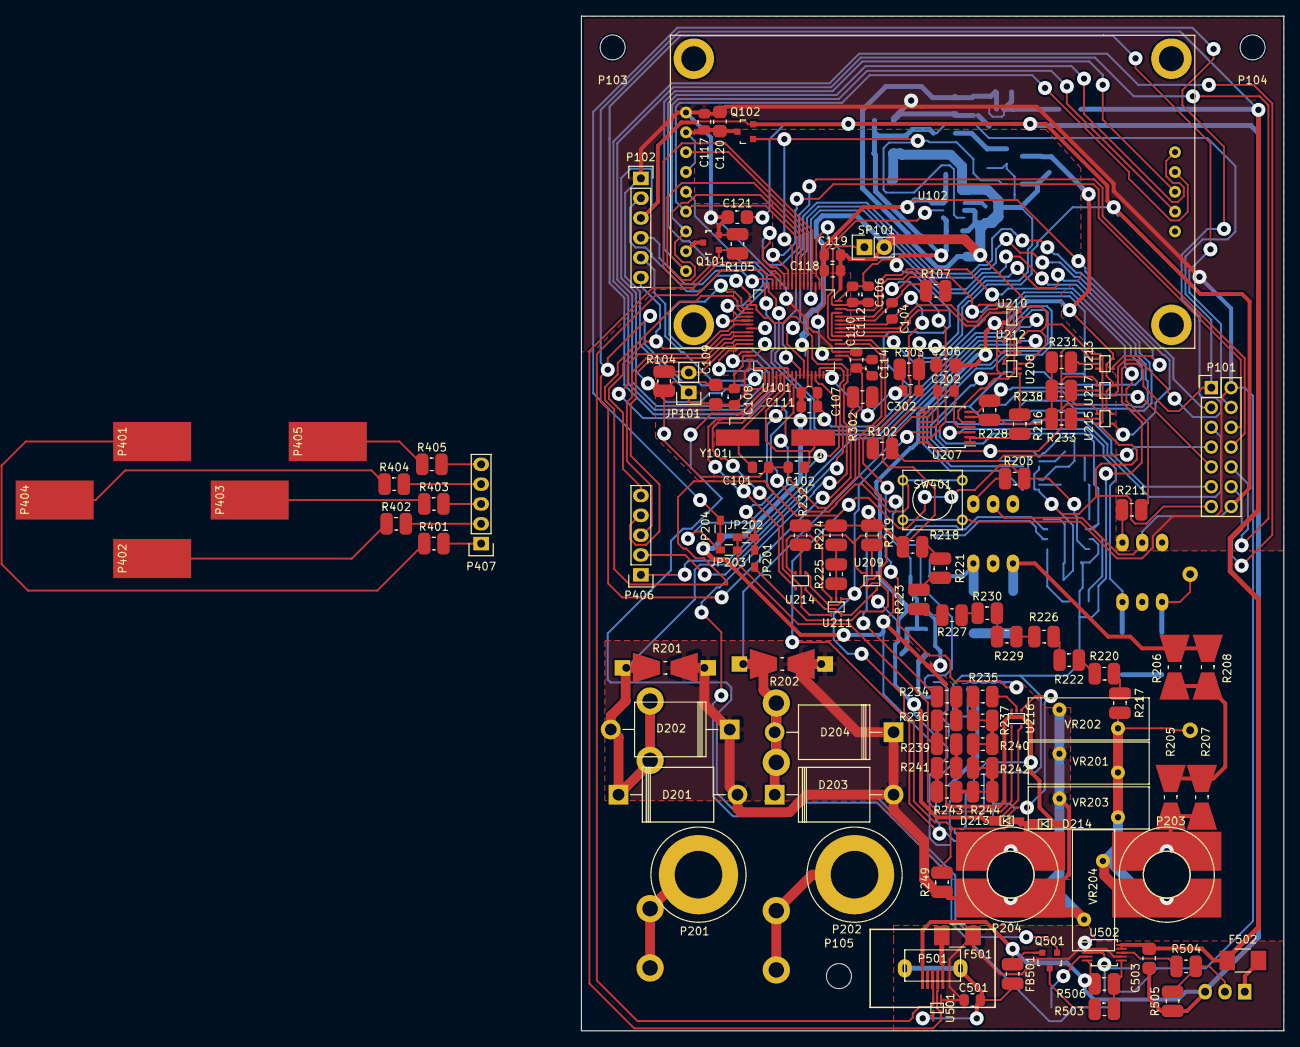
[picture p13: board Multimeter.kicad_pcb from above]

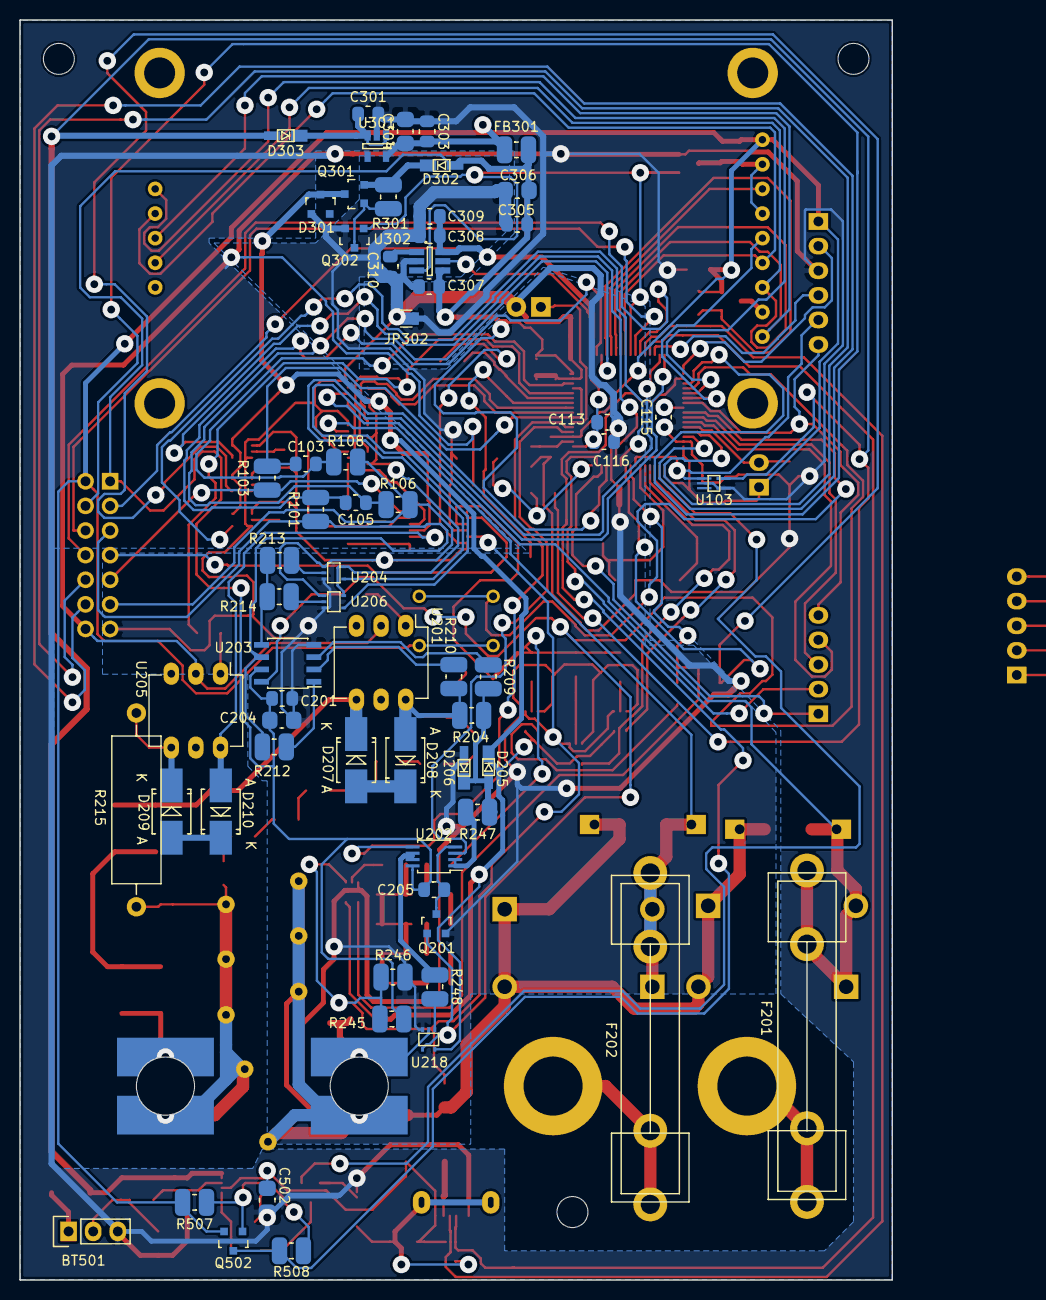
[picture p14: board Multimeter.kicad_pcb from below]

Board: 2 copper layers, 90.0 x 130.0 mm, 194 parts (64 on the bottom side), 146 nets.
