PreferLinux/open-source-multimeter/STM32F373 breakout/board.kicad_pcb

## KiCad design STM32F373 breakout/board.kicad_pcb (2016-07-17)

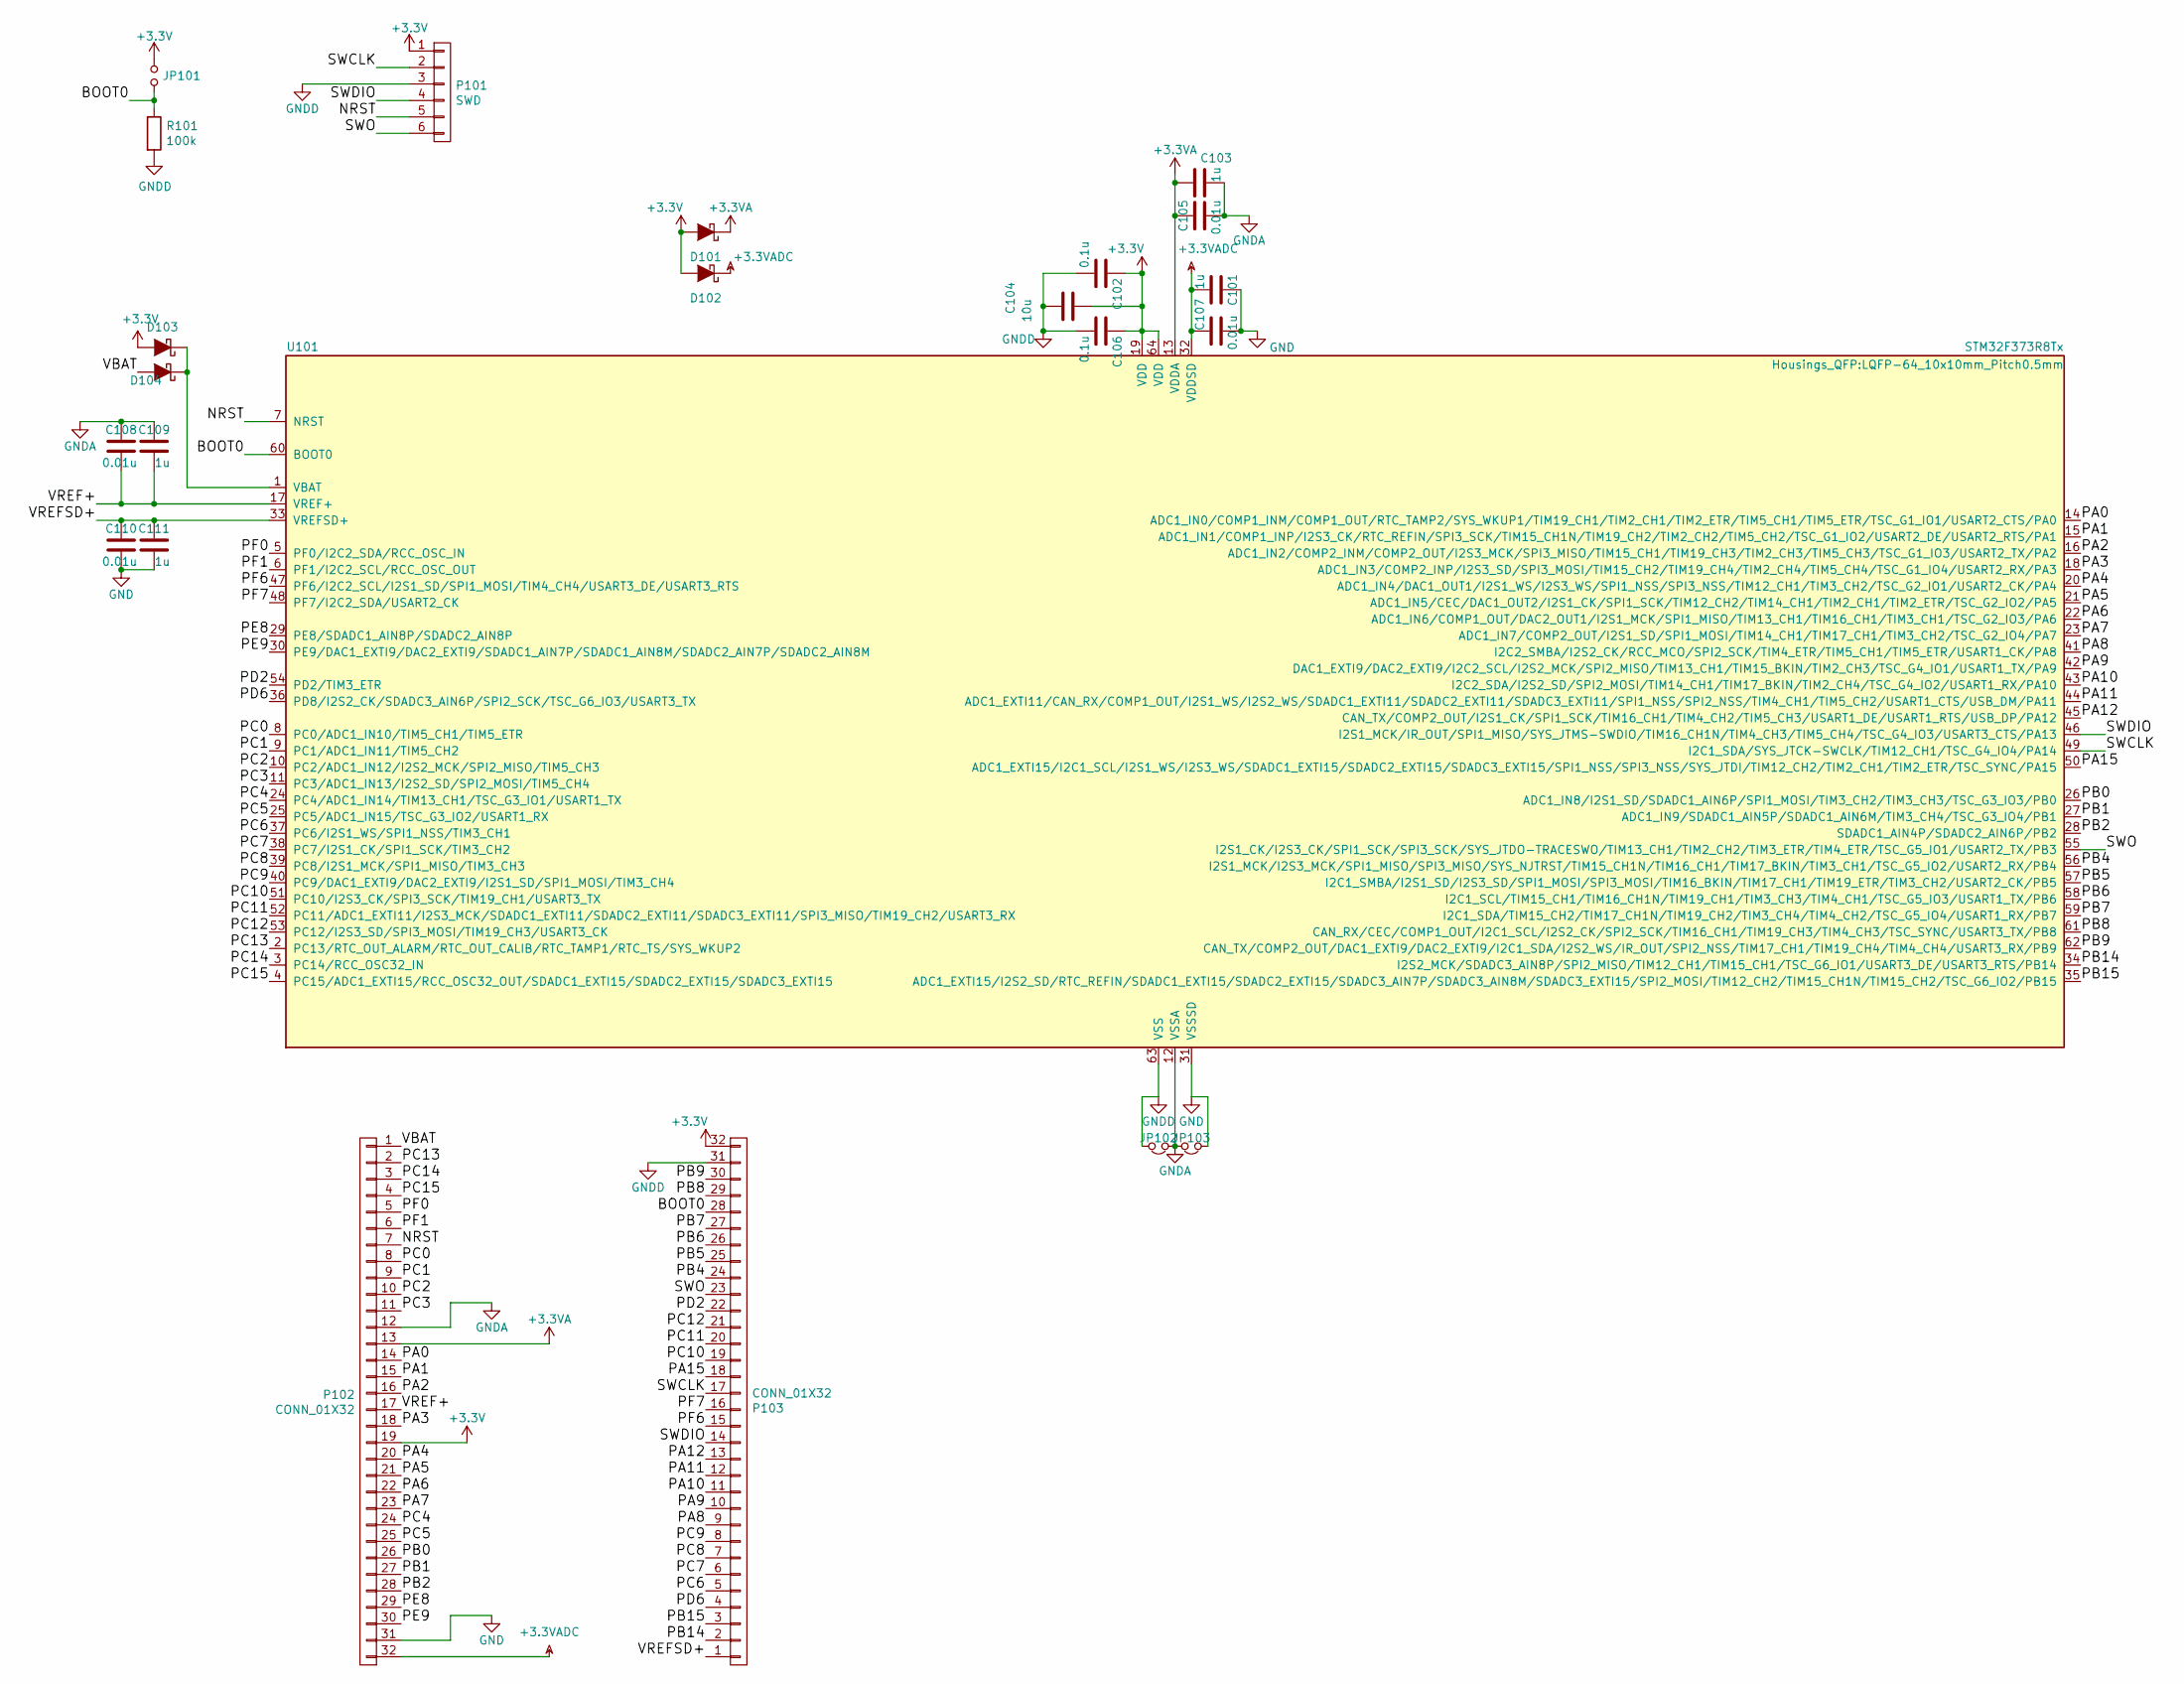
[picture p15: schematic board.sch, Multimeter – Overview]

Parts:
C101, C103, C109, C111: 1u; SMDuniversal_0603to0805_HandSoldering
C102, C106: 0.1u; SMDuniversal_0603to0805_HandSoldering
C104: 10u; SMDuniversal_0603to1206_HandSoldering
C105, C107, C108, C110: 0.01u; SMDuniversal_0603to0805_HandSoldering
D101, D102, D103, D104: D_Schottky; SC-90A
JP101: BOOT0; Pin_Header_Straight_1x02
JP102, JP103: Jumper_NC_Small; Net_Tie
P101: SWD; Pin_Header_Straight_1x06
P102, P103: CONN_01X32; Pin_Header_Straight_1x32
R101: 100k; SMDuniversal_0603to1210_HandSoldering
U101: STM32F373R8Tx; LQFP-64_10x10mm_Pitch0.5mm

Connections:
+3.3VA: C103.2, C105.2, D101.1 (K), P102.13, U101.13 (VDDA)
+3.3VADC: C101.2, C107.2, D102.1 (K), P102.32, U101.32 (VDDSD)
+3V3: C102.1, C104.2, C106.1, D101.2 (A), D102.2 (A), D103.2 (A), JP101.1, P101.1, P102.19, P103.32, U101.19 (VDD), U101.64 (VDD)
/BOOT0: JP101.2, P103.28, R101.1, U101.60 (BOOT0)
/NRST: P101.5, P102.7, U101.7 (NRST)
/PA0: P102.14, U101.14 (ADC1_IN0/COMP1_INM/COMP1_OUT/RTC_TAMP2/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)
/PA1: P102.15, U101.15 (ADC1_IN1/COMP1_INP/I2S3_CK/RTC_REFIN/SP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)
/PA2: P102.16, U101.16 (ADC1_IN2/COMP2_INM/COMP2_OUT/I2S3_MCK/S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)
/PA3: P102.18, U101.18 (ADC1_IN3/COMP2_INP/I2S3_SD/SPI3_MOSI/TI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)
/PA4: P102.20, U101.20 (ADC1_IN4/DAC1_OUT1/I2S1_WS/I2S3_WS/SPI1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)
/PA5: P102.21, U101.21 (ADC1_IN5/CEC/DAC1_OUT2/I2S1_CK/SPI1_SCK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)
/PA6: P102.22, U101.22 (ADC1_IN6/COMP1_OUT/DAC2_OUT1/I2S1_MCK/S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)
/PA7: P102.23, U101.23 (ADC1_IN7/COMP2_OUT/I2S1_SD/SPI1_MOSI/TI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)
/PA8: P103.9, U101.41 (I2C2_SMBA/I2S2_CK/RCC_MCO/SPI2_SCK/TIM4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)
/PA9: P103.10, U101.42 (DAC1_EXTI9/DAC2_EXTI9/I2C2_SCL/I2S2_MCK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)
/PA10: P103.11, U101.43 (I2C2_SDA/I2S2_SD/SPI2_MOSI/TIM14_CH1/TI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)
/PA11: P103.12, U101.44 (ADC1_EXTI11/CAN_RX/COMP1_OUT/I2S1_WS/I2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)
/PA12: P103.13, U101.45 (CAN_TX/COMP2_OUT/I2S1_CK/SPI1_SCK/TIM16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)
/PA15: P103.18, U101.50 (ADC1_EXTI15/I2C1_SCL/I2S1_WS/I2S3_WS/SD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)
/PB0: P102.26, U101.26 (ADC1_IN8/I2S1_SD/SDADC1_AIN6P/SPI1_MOSI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)
/PB1: P102.27, U101.27 (ADC1_IN9/SDADC1_AIN5P/SDADC1_AIN6M/TIM3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)
/PB2: P102.28, U101.28 (SDADC1_AIN4P/SDADC2_AIN6P/PB2)
/PB4: P103.24, U101.56 (I2S1_MCK/I2S3_MCK/SPI1_MISO/SPI3_MISO/S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)
/PB5: P103.25, U101.57 (I2C1_SMBA/I2S1_SD/I2S3_SD/SPI1_MOSI/SPI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)
/PB6: P103.26, U101.58 (I2C1_SCL/TIM15_CH1/TIM16_CH1N/TIM19_CH1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)
/PB7: P103.27, U101.59 (I2C1_SDA/TIM15_CH2/TIM17_CH1N/TIM19_CH2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)
/PB8: P103.29, U101.61 (CAN_RX/CEC/COMP1_OUT/I2C1_SCL/I2S2_CK/S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)
/PB9: P103.30, U101.62 (CAN_TX/COMP2_OUT/DAC1_EXTI9/DAC2_EXTI9/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)
/PB14: P103.2, U101.34 (I2S2_MCK/SDADC3_AIN8P/SPI2_MISO/TIM12_C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)
/PB15: P103.3, U101.35 (ADC1_EXTI15/I2S2_SD/RTC_REFIN/SDADC1_EX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)
/PC0: P102.8, U101.8 (PC0/ADC1_IN10/TIM5_CH1/TIM5_ETR)
/PC1: P102.9, U101.9 (PC1/ADC1_IN11/TIM5_CH2)
/PC2: P102.10, U101.10 (PC2/ADC1_IN12/I2S2_MCK/SPI2_MISO/TIM5_C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)
/PC3: P102.11, U101.11 (PC3/ADC1_IN13/I2S2_SD/SPI2_MOSI/TIM5_CH4)
/PC4: P102.24, U101.24 (PC4/ADC1_IN14/TIM13_CH1/TSC_G3_IO1/USAR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)
/PC5: P102.25, U101.25 (PC5/ADC1_IN15/TSC_G3_IO2/USART1_RX)
/PC6: P103.5, U101.37 (PC6/I2S1_WS/SPI1_NSS/TIM3_CH1)
/PC7: P103.6, U101.38 (PC7/I2S1_CK/SPI1_SCK/TIM3_CH2)
/PC8: P103.7, U101.39 (PC8/I2S1_MCK/SPI1_MISO/TIM3_CH3)
/PC9: P103.8, U101.40 (PC9/DAC1_EXTI9/DAC2_EXTI9/I2S1_SD/SPI1_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)
/PC10: P103.19, U101.51 (PC10/I2S3_CK/SPI3_SCK/TIM19_CH1/USART3_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)
/PC11: P103.20, U101.52 (PC11/ADC1_EXTI11/I2S3_MCK/SDADC1_EXTI11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)
/PC12: P103.21, U101.53 (PC12/I2S3_SD/SPI3_MOSI/TIM19_CH3/USART3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)
/PC13: P102.2, U101.2 (PC13/RTC_OUT_ALARM/RTC_OUT_CALIB/RTC_TA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)
/PC14: P102.3, U101.3 (PC14/RCC_OSC32_IN)
/PC15: P102.4, U101.4 (PC15/ADC1_EXTI15/RCC_OSC32_OUT/SDADC1_E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)
/PD2: P103.22, U101.54 (PD2/TIM3_ETR)
/PD6: P103.4, U101.36 (PD8/I2S2_CK/SDADC3_AIN6P/SPI2_SCK/TSC_G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)
/PE8: P102.29, U101.29 (PE8/SDADC1_AIN8P/SDADC2_AIN8P)
/PE9: P102.30, U101.30 (PE9/DAC1_EXTI9/DAC2_EXTI9/SDADC1_AIN7P/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)
/PF0: P102.5, U101.5 (PF0/I2C2_SDA/RCC_OSC_IN)
/PF1: P102.6, U101.6 (PF1/I2C2_SCL/RCC_OSC_OUT)
/PF6: P103.15, U101.47 (PF6/I2C2_SCL/I2S1_SD/SPI1_MOSI/TIM4_CH4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)
/PF7: P103.16, U101.48 (PF7/I2C2_SDA/USART2_CK)
/SWCLK: P101.2, P103.17, U101.49 (I2C1_SDA/SYS_JTCK-SWCLK/TIM12_CH1/TSC_G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)
/SWDIO: P101.4, P103.14, U101.46 (I2S1_MCK/IR_OUT/SPI1_MISO/SYS_JTMS-SWDI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)
/SWO: P101.6, P103.23, U101.55 (I2S1_CK/I2S3_CK/SPI1_SCK/SPI3_SCK/SYS_J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)
/VBAT: D104.2 (A), P102.1
/VREF+: C108.1, C109.1, P102.17, U101.17 (VREF+)
/VREFSD+: C110.2, C111.2, P103.1, U101.33 (VREFSD+)
GND: C101.1, C107.1, C110.1, C111.1, JP103.1, P102.31, U101.31 (VSSSD)
GNDA: C103.1, C105.1, C108.2, C109.2, JP102.1, JP103.2, P102.12, U101.12 (VSSA)
GNDD: C102.2, C104.1, C106.2, JP102.2, P101.3, P103.31, R101.2, U101.63 (VSS)
unnamed: D103.1 (K), D104.1 (K), U101.1 (VBAT)

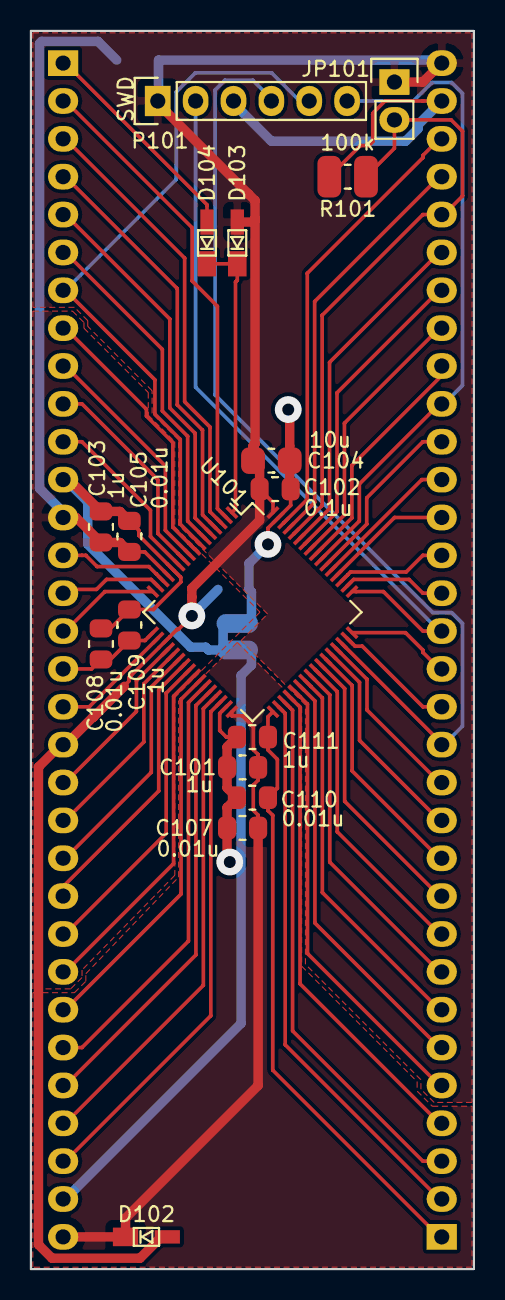
[picture p16: board board.kicad_pcb from above]

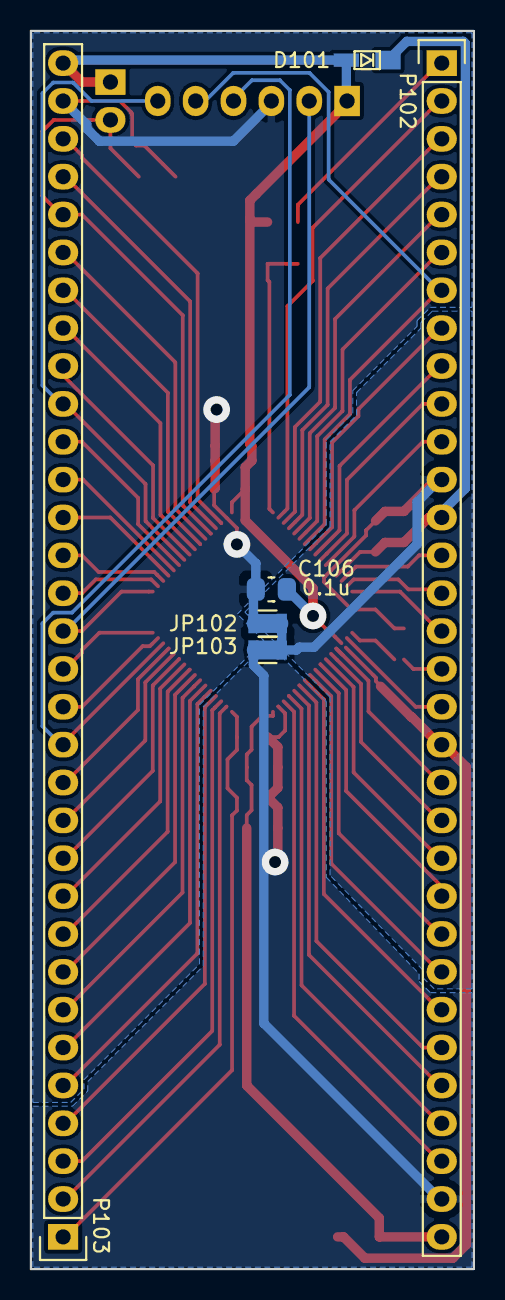
[picture p17: board board.kicad_pcb from below]

Board: 2 copper layers, 29.7 x 83.1 mm, 23 parts (6 on the bottom side), 64 nets.
