PreferLinux/open-source-multimeter/(commit log)

2016-06-09 Initial design files. Schematics nearly finished except for component values.
    [Controls.sch, External design.fcstd, Main IO.sch, Multimeter.kicad_pcb, Multimeter.sch, Power Supply.sch, USB.sch, voltage range divider values.ods]
2016-06-21 Updated schematics.
    Added speaker / buzzer, reset circuit (battery under-voltage lockout), changed battery charger IC.
    Altered Vout circuit.
    Added most resistor / capacitor values (those missing are either dependent on battery thermistor or ADC).
    Updated to show "correct" op-amps.
    [Controls.sch, Main IO.sch, Multimeter.sch, Power Supply.sch, USB.sch, voltage divider values.ods]
2016-06-21 Add battery voltage monitoring.
    [Controls.sch, Main IO.sch, Multimeter.sch, Power Supply.sch, USB.sch]
2016-06-22 Update External Design. Add battery sense capacitor. Update footprints.
    [Controls.sch, External design.fcstd, Main IO.sch, Multimeter.sch, Power Supply.sch, USB.sch]
2016-07-02 Added PCB layout.
    Also minor changes to schematic, the most major being changes
    to which MCU pins control what to make the PCB layout easier.
    [Controls.sch, External design.fcstd, Main IO.sch, Multimeter.kicad_pcb, Multimeter.sch, Power Supply.sch, USB.sch]
2016-07-04 Tied ground nets together, fixed clearance issues, added copper pours / zones.
    [Controls.sch, Main IO.sch, Multimeter.kicad_pcb, Multimeter.sch, Power Supply.sch, USB.sch]
2016-07-14 Add documentation. Fix some issues found while writing it.
    The issues fixed:
    Change R245-246 to 1M.
    Remove D211-212 and add D213-214.
    Power the analog switches from +V_int.
    Reconfigure range combination jumpers.
    Remove "GND" net.
    Correct values of C103-105, and add R106-108 (correcting values of R101-103).
    Change +V_int around to be based of +3.3VA instead of +BATT, and clamp to 3.5 V.
    Along with above, remove GND rail, mostly replacing with GNDA.
    Update PCB for changes.
    [Controls.sch, Main IO.sch, Multimeter.kicad_pcb, Multimeter.sch, Power Supply.sch, USB.sch]
2016-07-14 Added a resistor in COM to ensure clamping currents are handled correctly.
    [Controls.sch, Main IO.sch, Multimeter.kicad_pcb, Multimeter.sch, Power Supply.sch, USB.sch, voltage divider values.ods]
2016-07-14 Fix current circuit connection, PCB layout.
    The current measurement circuit has to connect directly to the Common terminal!
    The PCB layout had traces going between the pads of the Common terminal, where
    there's actually a non-plated hole. I've updated the footprint to include the hole,
    although unfortunately that produces about 20 DRC errors, and also re-routed stuff.
    Also updated the value of D301 to match a real Zener diode.
    [Main IO.sch, Multimeter.kicad_pcb, Power Supply.sch]
2016-07-17 Add STM32 breakout board. Update schematics PDF and docs.
    The PDF wasn't updated with the previous commit, but should have been. Likewise the documentation.
    The specific issue was the current measurement circuitry needed a direct connection to the Common terminal.
    The STM32 breakout board is for prototyping. Any QFP64 breakout boards I've seen have pins (or holes)
    on four sides, which is unsuitable for a breadboard. This is a simple breakout board if the net ties
    are cut and no components are placed. Otherwise it is actually a very minimal STM32F373 dev board.
    [board.kicad_pcb, board.sch]
2016-08-14 Connect the reset circuit to +BATT so that it actually works!
    [Multimeter.kicad_pcb, Multimeter.sch]
2016-08-24 Add the analog switch schematic component to the cache. Some PCB layout tweaks.
    [Controls.sch, Main IO.sch, Multimeter.kicad_pcb, Multimeter.sch, Power Supply.sch, USB.sch]
